kilian261299/mr2-reactive-leds/firmware/mr2-reactive-leds/README.md

# Firmware

This document describes the development of the MR2 Reactive LEDs firmware.

---

# Version History

## v1.0 – Initial Reactive Lighting

The first complete version of the firmware implementing the reactive lighting system.

### Features

- Reactive acceleration lighting
- Braking detection
- Left and right cornering effects
- Four diagnostic modes
- Rotary encoder brightness adjustment
- MPU6050 calibration
- Adjustable sensitivity

### Notes

This version used the raw accelerometer readings directly. While effective during normal driving, sustained gradients (such as hills) could cause the LEDs to remain in an acceleration or braking state.

---

## v1.1 – Dynamic Baseline Filtering

Improved acceleration detection by reacting to changes in acceleration rather than absolute sensor readings.

### Improvements

Instead of using the raw longitudinal acceleration value directly, the firmware continuously maintains a slowly updating baseline representing the vehicle's current orientation.

Acceleration effects are then calculated from the difference between the current reading and this moving baseline.

This allows the baseline to gradually follow long-term changes, such as driving uphill or downhill, while still responding quickly to genuine acceleration and braking events.

### Benefits

- Eliminates false acceleration detection on hills.
- Eliminates false braking detection on downhill sections.
- Produces smoother and more realistic vehicle response.
- Greatly improves real-world driving behaviour.

---

## v1.2 – Mode Cleanup

The firmware was simplified following validation of the accelerometer axis orientation and reactive lighting behaviour.

### Changes

- Removed X/Y/Z diagnostic modes.
- Removed one-off Left/Right test modes.
- Removed the White/current test mode.
- Removed the software Off mode.
- Power control is now handled by the physical master toggle switch.

The removal of diagnostic and test modes simplified the user interface and prepared the firmware for use in the final vehicle installation.

---

## v1.3 – New Modes and Effects

The firmware was updated with improved startup behaviour, idle lighting effects, and additional ambient lighting modes.

### Changes

- Added a startup sweep animation.
- Added idle breathing effect to the main reactive mode.
- Replaced the removed software Off mode with four static theme colours.
- Increased the total number of user-selectable modes to five.

### Startup Sweep

A one-off fading chase animation runs across both LED strips when the system powers on.

The startup animation completes before normal MPU6050 accelerometer-based reactive lighting begins.

### Idle Breathing

When the vehicle is stationary or experiencing minimal movement, the reactive lighting mode now produces a gentle breathing effect with an approximately four-second cycle.

The breathing effect is automatically overridden when genuine acceleration, braking, or cornering movement is detected.

### Theme Modes

Four selectable static colour themes were added:

- Purple
- Red
- Blue
- Green

These provide ambient lighting options when reactive vehicle-dynamics lighting is not required.

The firmware now provides five selectable modes in total.

---

## v1.4 – Colour and Reactivity Refinement

The firmware was refined to improve colour transitions and extend reactive behaviour across all lighting modes.

### Changes

- Tuned the acceleration fade target colour to reduce the green channel from 80 to 40.
- Reduced the yellow tint previously visible during the blue-to-orange acceleration transition.
- Extended movement-reactive brightness behaviour to all four theme modes.
- Extended cornering brightness shifts to all four theme modes.
- Extended idle breathing effects to all four theme modes.
- Hand-tuned final purple and green RGB colour values.

### Improvements

The four theme modes are no longer completely static.

They now respond to overall vehicle movement and left/right cornering in the same way as the main reactive mode, while retaining their selected base colour.

This provides consistent reactive behaviour across all five available lighting modes.

---

## v1.5 – Rotary Encoder Reliability Fix

The rotary encoder brightness control was updated to improve reliability and eliminate erratic brightness adjustments.

### Changes

The previous single-edge CLK detection method was replaced with full quadrature decoding.

The new implementation tracks both the CLK and DT signals simultaneously using a state-transition table.

### Improvements

The previous implementation could occasionally detect encoder transitions incorrectly.

This was particularly noticeable when the firmware was busy updating the LED strips, as the large LED update operation could cause the encoder to be sampled during a transition or contact bounce.

This could result in:

- Erratic brightness changes.
- Incorrect direction detection.
- Difficulty reliably reaching minimum brightness.
- Inconsistent encoder behaviour during rapid rotation.

The new full quadrature decoding method tracks valid CLK/DT state transitions and provides more reliable direction detection.

### Result

- Improved rotary encoder reliability.
- Reduced sensitivity to contact bounce.
- More consistent clockwise and counter-clockwise detection.
- Reliable brightness adjustment across the full brightness range.
- Improved ability to reach minimum brightness.

---

## v1.6 – Interrupt-Driven Encoder and Responsiveness Tuning

Following testing of v1.5, the rotary encoder brightness control was further refined.

Although the full quadrature decoding introduced in v1.5 improved direction reliability, brightness adjustment could still become less responsive during rapid encoder rotation.

This was caused by the main firmware loop performing large LED update operations. The two 160-LED strips are updated repeatedly, and these operations can temporarily prevent the encoder from being sampled frequently enough during fast rotation — a rotation could complete, several detents' worth of movement, entirely between two consecutive checks of the encoder pins.

### Moving to Interrupts

Polling (checking the encoder pins once per loop, however good the decoding logic) is fundamentally limited by how often the loop actually gets back around to checking. v1.6 removes that limitation by moving encoder reading onto **hardware interrupts** instead: `attachInterrupt()` is used on both the CLK and DT pins, configured to fire on `CHANGE` (any transition, either direction). This means an encoder transition is captured **the instant it happens**, regardless of what the main loop is doing at that moment — including in the middle of a slow LED strip update.

### Keeping the Interrupt Handler Minimal

The interrupt service routine (`encoderISR()`) does the same quadrature decoding as v1.5 — reading CLK/DT, looking up the transition in the same state-transition table, and accumulating valid movement — but deliberately does **nothing else**. No `Serial` printing, no LED updates, no `delay()`, no floating-point math. This matters because code running inside an interrupt handler blocks everything else on the microcontroller for its duration; keeping it to a few integer operations means it returns almost instantly, so it can't itself become a new source of timing problems. The accumulated movement is stored in a `volatile` counter, which the main loop reads separately.

### Draining Accumulated Movement in the Main Loop

The main loop doesn't do the decoding itself anymore — it just periodically drains whatever the ISR has accumulated (`processEncoderRotation()`). This copy-and-clear step is wrapped in `noInterrupts()`/`interrupts()` to make it atomic, so a transition can't be captured half-read if the ISR fires at the exact moment the main loop is checking it.

Draining uses a loop, not a single check — if several detents' worth of movement built up while the main loop was busy (e.g. during a slow LED update), all of it is applied at once, rather than only the most recent detent and the rest silently dropped. Any leftover partial movement (less than one full detent) is carried over to next time rather than discarded, so a rotation that happens to straddle two loop iterations doesn't lose precision.

### Detent Tuning

`stepsPerDetent` — how many valid quadrature transitions count as one physical "click" of the knob — was reduced from 4 (v1.5) to 2, so the brightness responds more directly to physical movement rather than needing two clicks to register a change.

### Improvements

- Added interrupt-driven rotary encoder handling.
- Both CLK and DT encoder signals are monitored using interrupts.
- Improved brightness adjustment responsiveness.
- Improved encoder performance during rapid rotation.
- Reduced missed encoder transitions when turning the knob quickly.
- Improved reliability during high-frequency LED update operations.
- Maintained reliable clockwise and counter-clockwise direction detection.
- Maintained stable minimum brightness control.
- Improved overall feel of the brightness control during normal use.

### Result

The rotary encoder now provides a more responsive and usable brightness adjustment experience while maintaining the reliability improvements introduced in v1.5.

The encoder can be rotated more quickly without losing as many brightness adjustments, making it easier to move rapidly through the full brightness range. Because encoder transitions are captured by interrupts rather than relying solely on the timing of the main firmware loop, brightness control remains responsive even while the LED strips are being updated.

---

## v1.7 – LED Output and Colour Refinement

The firmware was refined following continued development of the LED output and lighting behaviour.

### Changes

- Reworked LED brightness handling to use manual RGB channel scaling.
- Retained the NeoPixel library at maximum brightness while applying brightness directly to each colour channel before output.
- Improved consistency of colour ratios across different brightness levels.
- Refined the blue-to-orange acceleration colour transition.
- Reduced unwanted green contribution during acceleration colour transitions.
- Tuned the purple theme colour for a deeper, more controlled appearance.
- Retained full breathing effect depth across reactive and theme modes.
- Continued use of smoothed accelerometer values for stable reactive behaviour.
- Retained progressive acceleration, braking, and cornering responses.

### Manual RGB Brightness Scaling

Brightness is now controlled by directly scaling the red, green, and blue channels before the colour is sent to the LED strips.

This avoids relying on `setBrightness()` for normal runtime brightness control.

The approach provides more predictable colour behaviour during:

- Idle breathing.
- Acceleration response.
- Braking response.
- Cornering brightness changes.
- Static theme modes.

### Colour Refinement

The main reactive mode continues to transition from deep blue through a controlled violet-blue stage before reaching warm orange under stronger acceleration.

The green channel is deliberately kept low during the transition to prevent the LEDs from producing an unwanted pale purple, white, or yellow appearance.

The purple theme was also hand-tuned to use a controlled RGB value rather than a full-intensity mixture.

### Result

v1.7 provided a more consistent and visually controlled LED output while maintaining the established reactive lighting behaviour.

The firmware was now ready for further refinement of the accelerometer baseline system and real-world hill compensation behaviour.

---

## v2.0 – Smart Dynamic Baseline

v2.0 builds directly on the established v1.7 LED output, colour handling, reactive behaviour, and rotary encoder system.

The primary improvement in v2.0 is a more robust smart hill-compensation system designed to distinguish between long-term vehicle orientation changes and genuine dynamic vehicle movement.

### Smart Hill Compensation

The MPU6050 measures both gravity and dynamic acceleration.

Because the accelerometer is mounted to the vehicle, changes in vehicle pitch can alter the measured forward-axis acceleration even when the vehicle is travelling at a constant speed.

For example:

- Driving uphill can produce an apparent forward acceleration change.
- Driving downhill can produce an apparent braking change.

The hill-compensation system therefore maintains a slowly adapting accelerometer baseline representing the vehicle's current orientation.

Reactive acceleration and braking behaviour is calculated relative to this baseline.

### Smart Baseline Gating

Unlike the previous continuously adapting baseline system, v2.0 prevents the baseline from adapting during meaningful dynamic vehicle movement.

The baseline is frozen when the system detects:

- Significant forward acceleration.
- Significant braking.
- Significant lateral cornering movement.

This prevents genuine acceleration or braking events from being gradually absorbed into the baseline.

### Baseline State Machine

The smart baseline system operates using three states:

#### STABLE

The vehicle is considered sufficiently calm.

The baseline is allowed to adapt slowly to long-term changes in vehicle orientation.

This allows the system to gradually compensate for sustained gradients such as:

- Uphill driving.
- Downhill driving.
- Long-term changes in vehicle pitch.

#### DYNAMIC

Meaningful vehicle movement has been detected.

The baseline is completely frozen.

This includes:

- Acceleration.
- Braking.
- Cornering.

The baseline remains frozen for as long as meaningful dynamic movement continues.

This prevents genuine vehicle dynamics from being mistaken for a change in vehicle orientation.

#### SETTLING

Dynamic movement has stopped.

The baseline remains frozen temporarily while the vehicle settles.

A settling delay prevents the system from immediately adapting to the end of an acceleration, braking, or cornering event.

If dynamic movement resumes during this period, the system immediately returns to the DYNAMIC state.

Once the settling period has completed and the vehicle remains sufficiently stable, the system returns to STABLE and slow baseline adaptation resumes.

### Smart Baseline Behaviour

The intended behaviour is:

```text
Vehicle stationary / stable
        |
        v
Baseline slowly adapts
        |
        v
Hill or sustained gradient
        |
        v
Baseline gradually follows orientation change
        |
        v
Genuine acceleration detected
        |
        v
Baseline FREEZES
        |
        v
Acceleration held
        |
        v
Baseline remains FROZEN
        |
        v
Acceleration ends
        |
        v
SETTLING period
        |
        v
Vehicle becomes stable
        |
        v
Baseline slowly adapts again
```

### Also Included in v2.0

Carried over and retained unchanged from earlier versions, alongside the new baseline system:

- Accelerometer low-pass filtering.
- Acceleration, braking, and cornering dead zones, to prevent small/noisy movements from triggering reactive effects.
- Progressive (squared) acceleration, braking, and cornering response curves.
- Blue → violet-blue → orange acceleration colour transition.
- Red braking colour.
- Left/right cornering brightness bias.
- Five lighting modes (Main Reactive plus four static themes).
- Rotary encoder brightness control, mode switching (short press), and recalibration (long press).
- Startup sweep animation and calibration confirmation flash.

### Result

v2.0 substantially improved real-world hill behaviour compared to v1.1's always-adapting baseline: genuine acceleration and braking events are protected from being gradually absorbed into the baseline, while sustained gradients are still eventually recognised as the new normal once the vehicle settles.

The remaining limitation was that this entire system relied on the accelerometer alone. An accelerometer physically cannot distinguish "the sensor is tilted" from "the sensor is accelerating" — both produce an identical reading. v2.0's state machine and dead zones manage that ambiguity carefully, but can't fully resolve it. This became the focus of v3.0.

---

## v3.0 – Gyroscope + Accelerometer Sensor Fusion

v3.0 changes the fundamental approach to hill compensation: from accelerometer-only baseline tracking to gyroscope + accelerometer sensor fusion.

The motivation is the limitation identified at the end of v2.0 — an accelerometer alone cannot tell "tilted" apart from "accelerating." A gyroscope resolves this directly: a hill causes the vehicle to physically pitch (a rotation, which the gyro measures), while genuine forward acceleration does not. Tracking that rotation gives a real estimate of the vehicle's pitch angle, which can be used to calculate exactly how much of the raw forward reading is caused by gravity at that angle — and remove only that.

This section covers the full v3.0 development, including issues found and fixed during bench testing rather than a separate version bump — these were fixes to the intended v3.0 design, not new features.

### Gyroscope Pitch Tracking

The MPU6050's gyroscope measures rotation rate. For this vehicle's mounting orientation, pitch (the car's nose rising or dipping) is read from the gyro's Y-axis.

Integrating that rotation rate over time gives a running estimate of how much the vehicle's pitch angle has changed since the last reading.

### Complementary Filter

A pure gyro-integrated angle would drift slowly over time, since small measurement errors accumulate with every integration step. To correct this without losing the gyro's fast, accurate response, the firmware blends it with a second, independent pitch estimate calculated directly from the accelerometer (based on the direction gravity currently appears to be pulling).

The accelerometer-only estimate has the opposite trade-off: no long-term drift, but it's wrong whenever the vehicle is genuinely accelerating, since real acceleration adds to the reading in a way that looks like additional tilt.

The complementary filter blends the two, weighted mostly toward the gyro (98%) with a small continuous correction from the accelerometer (2%) — fast and responsive, but resistant to drift over the course of a drive.

### Accelerometer Reliability Gating

Found during code review: the original implementation always trusted the accelerometer's pitch estimate a little, even during strong acceleration or braking, when it's actively measuring gravity *plus* the vehicle's own motion rather than gravity alone.

The filter now calculates total accelerometer magnitude and compares it to 1g. The further that reading drifts from 1g, the less the accelerometer's pitch estimate is trusted — fading to fully ignored during a hard event, so the filter runs on the gyro alone until things settle back down.

### Gyro Zero-Rate Bias Correction

Found during bench testing: every real gyro reads a small nonzero rotation rate even sitting perfectly still (a manufacturing quirk called bias). Left uncorrected, integrating that constant offset produced continuous phantom pitch drift even when the sensor never moved — enough to get the state machine stuck in `DYNAMIC` permanently.

Fixed by measuring the gyro's average reading during calibration (while the board is genuinely still) and subtracting that measured bias from every subsequent gyro reading.

### Gravity Component Removal

Once the current pitch angle is known, the firmware calculates how much of the raw forward-axis reading is explained by gravity acting through that angle, and subtracts exactly that amount.

What remains is the genuine dynamic (non-gravity) component of the forward reading — real acceleration or braking — regardless of how long the vehicle has been on a slope.

### Gyro Sign Tuning

Same principle as `FORWARD_SIGN`/`SIDE_SIGN` elsewhere in this firmware: the correct sign for the gyro term can't be known in advance, only confirmed empirically. Bench testing showed a clear, consistent asymmetry — tilting nose-down produced the correct colour cleanly, but tilting nose-up briefly flashed the wrong colour before correcting itself. This is the signature of the gyro-integrated estimate momentarily tracking the wrong direction during fast rotation, before the accelerometer correction pulls it back.

Added a `PITCH_GYRO_SIGN` constant for this, flipped from `1` to `-1` based on that test result.

### Changes to the Smart Baseline System

- The forward/longitudinal axis no longer uses an adaptive baseline at all. Pitch compensation replaces that role directly and more accurately.
- The side/lateral axis (cornering) is unchanged — it still uses the v2.0 adaptive baseline, gated by the same state machine.
- The STABLE / DYNAMIC / SETTLING state machine from v2.0 is retained, but now only governs the side-axis baseline. It continues to provide the same protection against transient movement being misread as a change in vehicle orientation.

### Gating Signal Smoothing

Found during bench testing: the state machine's DYNAMIC/STABLE decision compared a raw, unsmoothed movement reading against a fairly tight threshold (0.075g). A single noisy sample could spike past that even at rest, contributing to the state machine getting stuck.

Added a dedicated smoothing pass for this gating signal, separate from the smoothing already used for LED output, applied before the threshold comparison.

### Behaviour

```text
Steady hill, constant speed
        |
        v
Pitch angle stabilises to match the gradient
        |
        v
Gravity's forward component is fully accounted for
        |
        v
LEDs read as calm / blue

Genuine acceleration (flat road or on a hill)
        |
        v
Cannot be explained by the pitch angle alone
        |
        v
Remains in the compensated signal
        |
        v
LEDs react normally
```

### Also Changed

- Renamed `baseX` to `calibrationAccelX` to reflect what it actually does now — a one-time input used to seed the pitch estimate, not an ongoing baseline like `baseY`/`baseZ` still are.
- Serial debug output now reports pitch two ways: absolute angle (what the compensation math actually uses, since gravity's real component depends on true tilt including any fixed mounting offset) and pitch relative to the last calibration (a more human-readable "degrees of hill" figure for reading the debug output).

### Side-Axis Gating: Rate of Change, Not Magnitude

Found during bench testing: the side-axis (Y/Z) state machine only checked the *size* of the movement reading against a threshold, not whether it was actually changing. A genuine, sustained offset (e.g. the sensor disturbed after calibration, then left in its new resting position without being recalibrated) looked identical to active movement — large — and the state machine could get permanently stuck in `DYNAMIC`, unable to ever adapt the side-axis baseline back to reality, since adaptation only happens in `STABLE`, and `STABLE` was never reached.

Fixed by gating on the *rate of change* of the movement signal instead of its raw size. Genuine cornering keeps changing throughout the event and is still correctly caught; a stale offset settles and stops changing, however large it is, and is now correctly allowed through to `STABLE` so the baseline can adapt itself back to reality.

This required rescaling the two threshold constants (`baselineStableThreshold`, `baselineDynamicReentryThreshold`), since a per-loop rate-of-change value is naturally much smaller than the magnitude value they used to compare against. Starting values are a reasonable guess, not yet verified against real driving data.

In practice this fix is expected to be low-impact on normal driving — a freshly calibrated car experiences genuine cornering as both large *and* changing, so the old and new gating logic should behave the same in that case. The difference only shows up in the narrower scenarios the bug affected: a long stop on a slope without power-cycling, or the sensor being disturbed mid-drive.

### Side-Axis Gating: Sustained Cornering Washout (Follow-on Fix)

A direct consequence of the rate-of-change fix above, found by reasoning through it rather than on the bench: a **sustained** corner — a roundabout, a long motorway sweeper, anything held at roughly constant lateral G for a few seconds — looks identical to a settled stale offset from a rate-of-change perspective. Both are "large, but not currently changing." The state machine couldn't tell "this stopped changing because nothing's happening" apart from "this stopped changing because the car is mid-corner at constant radius," so a long enough corner could reach `STABLE` and start adapting the baseline toward the current cornering G — fading the cornering LED effect to neutral while the car was still actively turning.

Mitigated (not eliminated) by slowing down two constants:

- `baselineDriftRate`: `0.05 → 0.003`. Even once `STABLE` is reached, adaptation now takes many seconds rather than well under one.
- `baselineSettleTime`: `750ms → 4000ms`. The state machine won't consider itself settled until a reading has been steady for a full 4 seconds, longer than most ordinary corners.

Together, a normal-length corner shouldn't get far enough through this pipeline to visibly fade; a genuinely stale offset (the sensor bumped and left, a long stop on an incline) still eventually self-corrects, just gradually.

**This is the third fix applied to this state machine without any real driving data to verify any of them against** (stuck-in-DYNAMIC → rate-of-change gating → this washout fix). That pattern was discussed directly: the system's only remaining genuine benefit is self-correcting *within a single drive* if the sensor is disturbed mid-journey, since parking on a slope is already handled by calibrating fresh on every boot, and cornering itself doesn't need it at all. Weighed against three rounds of speculative, unverified fixes, removing the whole system (calibrate `driftBaseY`/`driftBaseZ` once, never adapt, delete the state machine entirely) was seriously considered as the more robust option for the first real car test.

**Decision: keeping it for now**, with this explicitly flagged as a candidate for removal or simplification once real driving data comes in — either confirming it now works correctly, or showing it's not worth the complexity relative to the narrow benefit it provides.

### Untested Consideration: Road Bumps / Surface Noise

Not yet validated on real roads: whether potholes, expansion joints, or general road surface roughness (a real factor on UK roads) could trigger brief false colour reactions.

The two existing defences — dead zones (ignoring anything below `0.04g`/`0.12g`/`0.08g`) and smoothing — are tuned to reject small/gradual noise, but a sharp bump can produce a spike well above those thresholds in a single instant, and the smoothing is deliberately responsive (so genuine hard braking doesn't feel laggy), which limits how much it can reject a brief jolt too. A bump and the start of genuine hard braking look mathematically similar in that first instant — both are a sudden spike — so the system can't yet fully distinguish them by shape, only by size.

Some reason for optimism: the car's suspension sits physically between the road and the sensor, and already mechanically filters out a lot of sharp impact before it reaches the chassis — a bench test shaking the board by hand produces a sharper, higher-frequency jolt than most real bumps transmitted through a sprung, damped suspension, so it's likely a worse-case preview rather than a representative one.

This is one of the specific things to watch for during real-world driving. If it turns out to be a real problem, possible fixes (not yet implemented, each with a trade-off against responsiveness to genuine events):

- Heavier smoothing.
- Wider dead zones.
- A minimum-duration requirement — only react once a spike has been sustained for some threshold (e.g. ~100ms+), since bumps are typically much shorter-lived than genuine acceleration/braking events.

### Post-Install Update: LED Count

Not part of the original v3.0 development — added afterward, once the LED strips were physically cut to fit final mounting. `NUM_LEDS_LEFT`/`NUM_LEDS_RIGHT` updated from `160` to `80` to match. See the build log's "Build Change: LED Strips Cut to Fit Final Mounting" entry for the hardware side of this.

### Result

v3.0 is intended to resolve the core limitation carried through every previous version of the hill-compensation system: rather than carefully managing the ambiguity between "tilted" and "accelerating," it removes the ambiguity directly by using the MPU6050's gyroscope — a sensor that was physically present on the chip all along (the MPU6050 is a combined accelerometer + gyroscope), but whose readings earlier versions requested and then discarded without using. Bench testing confirmed the forward-axis pitch compensation working as intended, including recovering correctly from a large, sustained reorientation.

The side-axis (cornering) baseline system from v2.0 is retained, kept deliberately despite three rounds of unverified fixes during this version (see above) — its narrow remaining benefit (self-correcting mid-drive without a manual recalibration) was judged worth one more real-world test before deciding whether to simplify or remove it.

Firmware was installed for real-world car testing as of this version. See v2.1 below for what that testing found and the resulting development direction.

---

## v2.1 – Field Tuning (Branches from v2.0)

Following real-world driving in both v3.0 and v2.0 (see v3.0's Result above), this version branches from **v2.0**, not v3.0. This section explains why, and documents the one tuning change made so far.

### Why v2.0, Not v3.0

The same drive tested both versions.

**v3.0's result was ambiguous.** Logged data showed the forward-axis pitch estimate swinging significantly (double digits, degrees) during hard acceleration — consistent with the gyro absorbing genuine acceleration as if it were a hill, the exact failure mode the accelerometer-reliability gating was meant to prevent. However, this is **not confirmed** — the test run wasn't verified to be on flat ground, so the same data is equally consistent with a genuine road gradient. Untangling the two requires a controlled test (hard acceleration on confirmed-flat ground) that hasn't been done yet.

**v2.0's result was unambiguous and positive.** Braking and cornering both worked well. A real hill, driven at steady speed, correctly settled to blue. The one clear problem found — acceleration rarely reaching true orange — turned out to be a shared tuning issue affecting both versions equally (see below), not something specific to either compensation approach.

Given one version has a confirmed-working, if imperfect, result, and the other has an open question that needs further isolated testing to resolve, development focus moved to tuning v2.0 rather than continuing v3.0 immediately.

**This is provisional, not final.** v3.0's gyroscope approach isn't abandoned — it's paused pending a proper flat-ground test to resolve the ambiguity above. If that test confirms the drift concern, v3.0 would need real design changes (e.g. limiting how far the gyro can drift before forcing a correction) before it's worth continuing. If it turns out to be genuine road gradient all along, v3.0's approach may simply need the same kind of tuning v2.1 is getting here.

### Change: Acceleration Response Range

`accelerationResponseG` lowered from `0.35` to `0.18`.

Logged driving data (from the same drive, captured while running v3.0 — the underlying accelerometer data is the same sensor either way) showed hard acceleration peaking around `0.17g`. Against the old `0.35` target, even a hard launch only reached partway through the blue → orange transition — a brief violet flash, never true orange, matching what was reported: "can only briefly get it to go purple to orange when taking off very fast in 1st gear." `0.18` was chosen just above that logged peak.

This is a first estimate from a single data point, not a fully characterised response curve. May need further adjustment once more driving data — a range of gentle/moderate/hard accelerations, not just one hard launch — is available. Braking (`brakingResponseG = 0.40`) and cornering (`corneringResponseG = 0.35`) were left unchanged, since both were already reported working well.

### Change: LED Count

`NUM_LEDS_LEFT`/`NUM_LEDS_RIGHT` changed from `160` to `80`, matching the LED strips as physically cut for final mounting. v3.0 already had this fix (it was made directly to v3.0 while that was the active version); v2.0 did not, since it wasn't in active use when the strips were cut. Now carried over to v2.1 since this is the version actually being run in the car.

### Also Noted (Not Yet Changed)

**Braking doesn't trigger during upshifts in v2.0**, unlike v3.0 where it did. Likely explanation: v2.0 doesn't have v3.0's pitch-compensation erosion pulling the forward signal down toward zero during sustained acceleration, so the smoothing filter has a genuinely elevated, stable signal to blend against — a brief upshift dip may get partially smoothed out rather than crossing the braking threshold. Considered low priority (cosmetic, not core reactive behaviour) and not addressed in this version.

### Result

v2.1 is the currently active development branch, based on v2.0's confirmed-working real-world behaviour rather than v3.0's still-unresolved pitch question. The one identified shared issue (acceleration response range) has been corrected with a first-estimate fix, pending further driving data to refine it. v3.0 remains available and is not considered abandoned — see "Why v2.0, Not v3.0" above for what would need to happen to revisit it.

**Confirmed on further real driving**: braking and cornering both continued to work well. Acceleration correctly reached true orange with the tuned response range — confirming that fix. A new issue was found: on a sufficiently long, sustained acceleration, the display could fade back to blue before the acceleration actually ended.

**Note on file integrity**: partway through investigating the fade issue below, an intermediate build was briefly and mistakenly shipped as "v2.1" with the (later rejected) full-freeze fix already applied, differing only in its internal version label. This was caught and corrected — the file distributed as v2.1 is confirmed to match the description in this document exactly (tuned acceleration response and LED count only, nothing else). Documented here for a clean record; no impact on the firmware description above.

**The fade issue, investigated**: traced to `gravityX/Y/Z`, a tracker that feeds the STABLE/DYNAMIC/SETTLING gating decision. Unlike `driftBaseX/Y/Z` (the actual output baseline, which correctly freezes during `DYNAMIC`), this tracker was updating unconditionally, every loop, regardless of state. Over several seconds of genuinely sustained acceleration, it would slowly catch up to the elevated reading, shrinking the gating signal toward zero even though real acceleration was still happening — eventually fooling the state machine into thinking things had calmed down, which released the real baseline to re-adapt and fade the display.

**A full fix was built and reasoned through, but not shipped.** Freezing `gravityX/Y/Z` during `DYNAMIC`/`SETTLING` (the same way the real baseline is already protected) does stop acceleration from fading — but the same signal also does a second job: eventually recognising that a sustained reading is a real hill, not an event, and releasing the baseline to absorb it as the new normal. Freezing it unconditionally removes that second job too. A plain accelerometer genuinely cannot tell "long sustained acceleration" apart from "constant-grade hill" — both produce the same signal, held roughly constant over time. This is the same structural ambiguity v3.0's gyroscope exists to resolve; there is no cleverer accelerometer-only heuristic that resolves it. Given the choice between "hills fade correctly, acceleration can prematurely fade" (v2.1's original behaviour) and "acceleration never fades, hills likely never fade either" (the full fix), the full fix was judged a worse trade-off, not a genuine improvement, and was not shipped as v2.2.

---

## v2.2 – Milder Acceleration-Hold Tuning

Branches from the confirmed-clean v2.1 above. A milder compromise for the same fade issue, rather than the full (rejected) fix — slows down the relevant trackers instead of freezing them, buying more headroom for genuine sustained acceleration without removing hill-absorption altogether.

### Change: Slower Gating Tracker

`gravitySmoothing` lowered from `0.008` to `0.003`.

Rather than freezing this tracker during `DYNAMIC` (the rejected full fix), it's simply slowed down — roughly tripling how long a sustained reading needs to persist before being treated as "the new normal," based on this loop's approximate rate (around 2.5s before, around 6–7s now). A typical hard acceleration run (a few seconds) should get meaningfully more headroom before fading; a genuine hill (tens of seconds or more) should still be absorbed correctly, just somewhat more slowly than before. Both directions are affected together — this doesn't resolve the underlying ambiguity, only shifts where the trade-off sits. Untested at time of writing.

### Change: More Stubborn Dynamic Re-Entry

`baselineDynamicReentryThreshold` lowered from `0.075g` to `0.055g`.

Makes the state machine more reluctant to consider things "calm enough" once an event is underway, so a brief lull during a sustained pull is less likely to let it slip back toward `STABLE` prematurely. Same event-holding goal as the change above, different mechanism. Untested at time of writing. If the combined result overshoots (things stay "locked in" for too long, e.g. noticeably after a real stop), this is one of the knobs to walk back individually.

### Change: Split Smoothing Constants (Acceleration, Braking, Cornering, Movement)

Previously, one shared `accelerationSmoothing` constant governed the low-pass filtering for acceleration, braking, cornering, *and* the theme modes' overall movement brightness — despite the name, it wasn't acceleration-specific at all. This meant tuning it to help acceleration hold its colour longer would have also made braking and cornering feel less snappy, even though neither was part of the problem being fixed (both were already reported working well).

Split into four separate constants:

- `accelSmoothing = 0.10` — acceleration only. Lowered from the previous shared `0.15`, for a steadier displayed colour, less prone to dipping during a brief lull in a sustained pull. Trade-off: slightly slower to reach full colour at the start, and slightly slower to fade back to blue once acceleration actually ends.
- `brakeSmoothing = 0.15` — braking only. Restored to the original value, left untouched.
- `corneringSmoothing = 0.15` — cornering only. Restored to the original value, left untouched.
- `movementSmoothing = 0.15` — theme modes' movement brightness only. Restored to the original value, left untouched.

The forward-axis filter now picks `accelSmoothing` or `brakeSmoothing` each loop based on the current raw reading's sign — a single continuous filter over one signal (`smoothedForwardG`), but with a blend rate that can change depending on whether the current instant looks like acceleration or braking.

### Expected Behaviour Change, v2.1 → v2.2

All three changes above act in the same direction — more reluctant to release an active reading. Expected effects, by scenario:

- **Short, everyday acceleration**: little to no noticeable change.
- **Long, sustained hard acceleration** (the target case): should hold its colour noticeably longer before fading, if it fades within a typical pull at all.
- **Real hills at steady speed**: likely to take longer to settle to blue than v2.1 did — this is the actual cost of the fix, not an unintended side effect, and the main thing to verify on the next real hill test.
- **Braking**: should feel unchanged from v2.1, now that its smoothing is isolated from the acceleration-specific tuning.
- **Cornering**: should also feel unchanged, for the same reason.

### Result

**Confirmed on real driving.** Works well overall, mainly noticeable accelerating in 1st and 2nd gear. Braking and cornering unaffected, as expected.

Two things found:

- **Higher gears rarely reach true orange.** `accelerationResponseG` (0.18) was set from a single logged 1st-gear launch peaking at 0.17g. Higher gears produce much lower forward g for the same "hard acceleration" feel, so they were likely peaking well under 0.18g the whole time. Addressed in v2.3 below.
- **Very steep downhill sections trigger braking (red) heavily/frequently**, beyond what the actual brake pedal input alone would suggest. Not addressed in v2.3 — see that section for why this is a harder problem than the acceleration one.

---

## v2.3 – Higher-Gear Acceleration Tuning

Branches from v2.2, based on its first real driving feedback (above).

### Change: Acceleration Response Range, Again

`accelerationResponseG` lowered from `0.18` to `0.12`.

0.18 worked for 1st/2nd gear but higher gears (lower forward g for the same "hard" feel, due to less torque multiplication) rarely reached orange at all. 0.12 gives higher gears more room on the ramp.

**This is a physics-based estimate, not measured data.** Unlike the original 0.18 figure — derived from a real logged data point — there's no way to log a real number for higher-gear pulls anymore: the board now runs permanently on vehicle power, and USB (needed for Serial logging) can never be connected at the same time as vehicle power (see the build log's backfeed entry). The next drive on this value is the test. If normal light-throttle driving now reaches orange too easily, raise back toward ~0.15; if higher gears still don't get there, lower further toward ~0.09–0.10.

### Steep Downhill Braking: Investigated, Not Fixed Here

Also reported from the same v2.2 drive: very steep downhill sections trigger heavy, frequent braking (red) beyond what the actual pedal input would suggest.

**Root cause identified at the time:** a steep grade change freezes `driftBaseX/Y/Z` (see `updateSmartBaseline()`) the same way genuine braking does — and on a winding descent, repeated real braking can keep that baseline frozen for the whole hill, since each brake application resets the freeze/settle timer before the baseline ever catches up to the new pitch angle. The leftover gravity offset from the grade then stacks on top of genuine brake input, reading as harder and more frequent braking than the pedal alone caused.

At the time, this was believed to be an inherent, unfixable ambiguity of the accelerometer-only approach. **That turned out to be incomplete** — see v2.3's Result below and v2.4.0/v2.4.1, which found and fixed a specific contributor to this that had nothing to do with the fundamental hill-vs-braking ambiguity.

### Code Review Follow-Up (Before First Drive)

A code review of this file, run before it had been driven, found several issues fixed in place rather than shipped as a separate version — none of them re-tune the values above:

- **Modes 1–4 were silently decoupled from the acceleration tuning.** The static colour themes scaled their movement brightness against a hardcoded `0.50g` threshold that had never moved across three rounds of `accelerationResponseG` tuning (`0.35` → `0.18` → `0.12`). They now use `accelerationResponseG` directly. **This is a genuine, previously-unnoticed bug fix and a real behaviour change** — Modes 1-4 will now swing to full brightness much more readily than before, where they barely reacted to movement at all.
- `calibrateMPU6050()` now refuses to run (flashes red, returns immediately) if the vehicle isn't stationary, instead of silently averaging a moving-vehicle reading into the calibration baseline on an accidental long-press while driving.
- The repeated "dead zone → range → ratio → clamp → square" intensity curve (acceleration, braking, cornering, theme brightness) was unified into one `squareRatio()` helper, which also floors its range argument away from zero — closes off a possible future divide-by-zero if `accelerationResponseG` is ever tuned down close to `accelerationDeadZone`.
- Removed dead code: three unused `baseline*Threshold` constants, and an unreachable re-check inside `updateSmartBaseline()`'s SETTLING state.
- Minor efficiency/robustness cleanup: `setStrip()` now skips rewriting LED data when output is unchanged from the previous frame; `blueToOrange()` is called once per loop instead of twice; the gravity "not yet initialised" check now uses an explicit flag instead of a fragile exact-zero float comparison.

### Result

**Confirmed on real driving.** Works "almost perfectly": higher gears now reach true orange (confirming the `0.12` tuning), and Modes 1-4 are confirmed noticeably livelier (confirming the code-review fix). Braking and cornering unaffected, as expected.

**One new issue found, not present on earlier versions:** flickering between red (braking) and blue (idle) while going downhill, with no braking input needed at all — a different, more disruptive symptom than the "heavy/frequent braking" originally reported on v2.2. Traced back to **v2.1 → v2.2** (not this version's own acceleration-threshold change or code review): v2.2's `gravitySmoothing` and `baselineDynamicReentryThreshold` changes, made specifically to help sustained acceleration hold its colour, also slowed how fast a downhill grade gets absorbed and made the state machine easier to re-trigger before it settled — together producing a freeze/partial-catch-up/re-trigger cycle on hills. Fixed in v2.4.0 below, without reverting the acceleration benefit.

---

## v2.4.0 – Downhill Flicker Fix, Attempt 1 (Superseded)

Branches from v2.3, fixing the downhill red/blue flicker found on that version's first drive (see v2.3's Result above).

### Change: Direction-Aware Gravity Smoothing (Forward Axis Only)

`gravitySmoothing` (0.003, the v2.2 rate that protects sustained acceleration from fading) is no longer applied uniformly to the forward axis. A new constant, `gravitySmoothingBraking` (`0.008`, the original pre-v2.2 rate), is used instead whenever the current forward-axis excursion is in the **braking direction** — which a downhill grade shares, since both show up as a sustained shift on the same axis, same sign.

This works because acceleration and braking/downhill-grade are distinguishable by sign on the same axis, even though an accelerometer can't otherwise tell "tilted" from "accelerating." Each loop, `readAcceleration()` checks the sign of the raw forward reading relative to the current gravity estimate (before that estimate updates) and picks the smoothing rate accordingly:

- **Accelerating** → `gravitySmoothing` (`0.003`, unchanged from v2.2/v2.3) — sustained hard pulls still get the full ~6-7s of held colour before the baseline would start absorbing them.
- **Braking / downhill** → `gravitySmoothingBraking` (`0.008`, restored) — the baseline recognises and absorbs a hill grade at roughly the v2.1 rate again, well before the freeze/re-trigger cycle has a chance to repeat visibly.

This is a different kind of fix than the blunt mitigations considered and rejected for v2.3 (raising `brakingDeadZone`/`brakingResponseG`, which would have dulled genuine light braking everywhere). It doesn't touch the dead zone or response range at all — it only changes how fast the *gating* signal recognises a sustained condition, and only in the direction where fast recognition doesn't cost anything: real braking already ran fine at this exact rate across v2.0 and v2.1, before v2.2 slowed it down uniformly for acceleration's sake.

`baselineDynamicReentryThreshold` (`0.055`, also lowered in v2.2) was **left unchanged**. The gravity-rate split should already resolve the flicker by keeping the gating signal closely tracked during braking/downhill excursions; if flicker persists, that threshold is the next thing to revisit.

### Result

**Drive-tested: no improvement.** Downhill flicker unchanged from v2.3. Uphill and flat were both unchanged too — but they were already fine before this change, so that's not evidence the fix did anything; it's consistent with the fix having no effect at all.

**Root cause of the fix not working:** a hill pitch doesn't only shift the forward axis (X) — it shifts the vertical axis (Z) at the same time, since both are involved in the same rotation. This version only made `gravityX` direction-aware; `gravityZ` was left on the plain, slow `gravitySmoothing` rate throughout. Since the state machine's gating signal (`dynamicMovementG`, in `updateSmartBaseline()`) is a combined magnitude across all three axes, `gravityZ`'s slow recovery kept that combined signal elevated for the old ~6-7s duration regardless of how fast `gravityX` alone recovered — so the baseline never got released to adapt any sooner than it did on v2.3. Fixing one of the two coupled axes did nothing on its own. Fixed in v2.4.1 below.

---

## v2.4.1 – Downhill Flicker Fix, Attempt 2 (Final Version, Confirmed)

Branches from v2.4.0, extending the direction-aware fix to the axis it missed.

### Change: Extend the Direction Split to gravityZ

`gravityZ` now uses the same `gravitySmoothingForward` rate and the same direction flag as `gravityX` (not a separate one) — a hill/braking event is fundamentally a forward-axis phenomenon, and `gravityZ`'s shift is a side effect of that same event, not an independent one needing its own direction test. `gravityY` (the lateral/cornering axis) is left on the plain `gravitySmoothing` rate — a straight hill, with no steering input, shouldn't significantly couple into that axis, and cornering already has its own separate handling.

With both coupled axes now settling quickly in the braking/downhill direction, the combined gating signal should drop below threshold at roughly the v2.1 rate again, letting `driftBaseX/Y/Z` resume adapting as soon as v2.4.0 intended it to.

`baselineDynamicReentryThreshold` (`0.055`) is still unchanged. If flicker persists even with both axes fixed, that threshold — which governs how easily the state machine gets knocked back into "frozen" by any remaining noise or disturbance on the hill, independent of how fast the gravity trackers themselves recover — is the next and now more likely culprit.

### Result

**Confirmed on real driving.** Built immediately following v2.4.0's failed drive test; the next drive confirmed it worked — the downhill flicker is gone, and acceleration-hold and braking both feel unchanged from v2.2/v2.3, exactly as expected since this fix only touched how fast the hill-compensation baseline settles.

**v2.4.1 is confirmed as the final firmware version — the core reactive-LED project is complete.** `baselineDynamicReentryThreshold` was flagged as the next thing to try if this didn't work; since it did, that's no longer a live concern. v3.0/v3.1's gyroscope approach remains parked, not needed after all.

---

## v3.1 – Ported Tuning, Gyro Fusion (Parked, Not Pursued Further)

Branches from v3.0: the same acceleration response tuning as v2.1 (`accelerationResponseG` to `0.18`), plus `pitchComplementaryAlpha` lowered from `0.98` to `0.90` in an attempt to reduce the pitch drift seen in v3.0's original real-world test.

Tested once, visually. Braking worked well. Acceleration briefly reached orange only under hard 1st-gear launches, fading back to blue in under a second even while still accelerating — noticeably faster than v2.1's fade, not slower. The timing closely matches the pitch drift seen in the original v3.0 log, strengthening (though not fully confirming, absent a controlled flat-ground test) the theory that the gyro is absorbing genuine acceleration as if it were a hill.

**Parked, not pursued further.** v3.0/v3.1's gyroscope approach was expected to outperform the accelerometer-only v2.x line at exactly this problem; the one real-world test so far suggested the opposite. v2.x's line of tuning reached a good enough result with v2.4.1 (adopted as the final firmware version, see above), so the flat-ground test that would have properly settled the pitch-drift question was never needed and won't be pursued. Not deleted or considered a dead end in principle — just not required to finish this project.

---

## v4.0 – Audio-Reactive Mode (Drafted, Not Yet Bench-Tested)

New version *line*, not a v2.x point release — branches from the final `v2.4.1` above (v3.x's gyroscope work is parked and unrelated), adding the [audio-reactive LED feature](../../docs/audio-reactive-led-plan.md) on top of it. Nothing about v2.4.1's hill-compensation/baseline system changes; Mode 0 and the remaining theme modes are untouched.

### Change: Mode 1 Replaced Entirely

Mode 1 (previously a fixed purple theme, brightness-only reactive to movement like Modes 2–4) is replaced by a new audio-reactive mode — not added as a 6th mode, an explicit choice to keep the mode count at five. Modes 0, 2, 3, 4 keep their existing numbers and behaviour unchanged; only what used to live at slot 1 is different.

Ported from the bench-test sketch (`firmware/tests/04_audio_reactive_test/`), validated there against real music: reads the conditioning circuit's envelope on `GPIO1` (identical pin on both the bench-test board and this production board — the same chip, by design, so no remapping was needed), smooths it with the same fast-attack/slow-release curve, and drives a bar-graph visualizer — a growing/shrinking bar with a bouncing peak-hold marker — across **both** strips identically, rather than the whole-strip solid colour every other mode uses. One mono envelope, no left/right distinction the way cornering has one.

Colour snaps from cyan (quiet) to orange (loud) once the level clears a threshold, using **separate on/off thresholds** (hysteresis) rather than one — a single threshold let the level jitter right at the boundary on real music, which read as a rapid cyan/orange flicker blending into a washed-out white; a real bug hit and fixed on the bench-test sketch first, then carried over here from the start.

The bar's *length* represents audio level (the whole point of the visualizer) — its *LED brightness* is a separate, independent thing, capped by `userBrightness` exactly like every other mode's colour is, using the same scaling maths `setStrip()` already uses elsewhere in this file. The rotary encoder's brightness dial dims/brightens Mode 1 exactly like it does Mode 0.

### Change: Serial Safety Fix Applied File-Wide

`Serial.availableForWrite()` guards added not just around the new audio debug fields, but around the pre-existing periodic debug block and the mode-change print inherited from v2.4.1 — neither had this guard before. Same native-USB-CDC blocking bug found on the ESP32-C3 bench-test sketch: without a Serial Monitor open to drain the buffer, an unguarded print can block indefinitely and freeze the whole `loop()`, LEDs included. Not something the installed v2.x line has ever hit (it runs on permanent vehicle power, USB never connected there), but this file will be bench-tested and installed over USB during Phases 3–4, so it was worth fixing everywhere in this file, not just in the new code.

### Known Placeholder: audioFloor / audioCeiling

Carried over unchanged from Phase 2 bench testing (laptop/phone audio via a USB-C dongle): `audioFloor = 900`, `audioCeiling = 1300`. Almost certainly wrong for the real car radio — different source strength, a volume-dependent preout level, and BAT85 replacing the bench's 1N4007 all change the numbers these were calibrated against. Both are clearly commented in-file as needing retuning from real Serial readings once connected to the actual radio, the same way the originals were derived on the bench.

### Result

**Compiles clean** — 0 errors, 0 warnings — against the real `ESP32-C3 Super Mini` target (`esp32:esp32:nologo_esp32c3_super_mini`) via `arduino-cli`. **Not yet bench-tested**: the conditioning circuit components are with the `v2` PCB, not available for a bench rebuild at time of writing. First real test will be a semi-install directly against the car radio during Phase 4, powered over USB (never simultaneously with vehicle power) so Serial stays available for calibrating `audioFloor`/`audioCeiling` against real numbers.
