kilian261299/mr2-reactive-leds/docs/audio-reactive-led-plan.md

# Audio-Reactive LED Feature — Build Plan

A new, optional mode for the MR2 Reactive LEDs project: LEDs react to music from the car radio, in addition to the existing acceleration/braking/cornering reactivity. This is an addition layered on top of the completed core project — it does not replace or modify the existing v2.x firmware line.

---

## Circuit Design

**Note on D1 (the rectifier diode):** using a 1N4007 rather than the more typical small-signal choice (e.g. 1N4148) for this role, based on what was already on hand. The 1N4007 is a general-purpose power rectifier with much slower switching than a dedicated signal diode — normally a mismatch for audio-frequency work, but not a practical problem here, since the smoothing capacitor (C1) is deliberately the slow part of this circuit already, turning the rectified signal into a "how loud is the music right now" envelope over hundreds of milliseconds. The diode's speed was never going to be the limiting factor for something changing that slowly.

### Signal path overview

```
Front Left RCA  ──┐
Front Right RCA ──┼── mono-summed at the tap point
RCA ground/shield ─┘  (tapped in parallel — never cut the cable in series)
        │
        ▼
Conditioning circuit (see component list below)
        │
        ▼
ESP32 ADC pin (reads a 0–3.3V audio envelope)
        │
        ▼
Firmware: smooth (fast attack, slow release), drive a bar-graph visualizer
        │
        ▼
WS2812B LED strips (existing LEFT_LED_PIN / RIGHT_LED_PIN)
```

### Testing setup — full pipeline

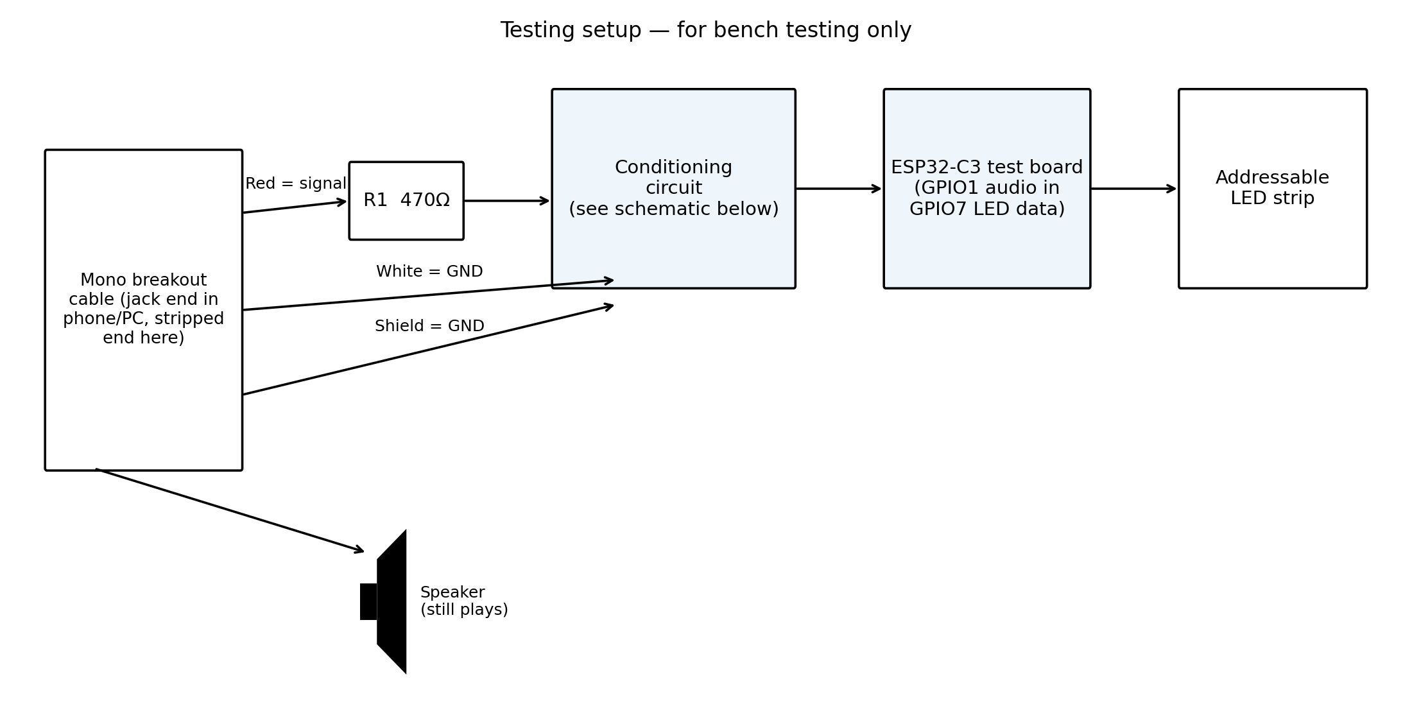
[picture p20: images/audio-circuit/testing_setup_overview.png]
Testing setup overview


This is the complete bench-test signal path: a 3.5mm breakout cable (jack end into a phone or PC, stripped end wired to the circuit), summed and conditioned, into a spare ESP32-C3 module, driving the addressable LED strip. This is the testing configuration only — the production install uses the car's actual RCA tap and the ESP32-C3 installed in the car, not a phone/PC or this spare board.

A small monitoring speaker is also tapped across the R wire and shared ground (not part of the conditioning circuit itself) so you can hear what's actually playing while watching the LED/Serial response — useful for correlating specific sounds (bass hits, vocals, silence) with the tuned behaviour during Stage A/B below.

**Testing board update:** originally planned around a full ESP32 dev board (`GPIO34`/`GPIO5`). A spare ESP32-C3 module turned out to be available instead, which is actually simpler: it's the same chip as production, so the audio ADC pin (`GPIO1`) is identical on both, and Phase 2 tuning carries straight into Phase 4 with no pin remapping. See the updated pinout table below.

### Testing circuit — schematic

Testing circuit schematic

### Testing circuit — component list

```
Red wire (signal) → R1 (470Ω) → D1 (1N4007) → Node B
White wire (ground — see note) ─┐
Shield wire (ground) ───────────┴── GND

Node B → C1 (2.2µF) → GND

Node B → R6 (10kΩ) → GND

Node B → ESP32-C3 (spare test module) GPIO1 (ADC input)
```

A small monitoring speaker taps directly across the red wire and shield, *before* R1 — a separate parallel branch off the raw source connection, not part of the conditioning circuit's signal path.

**White wire note:** on this particular breakout cable, the "white" wire turned out to have continuity with the shield — it's a second ground/drain wire, not a real left-channel conductor (common on cheap 3.5mm pigtail cables, which don't follow RCA's white=L/red=R convention). It ties to the same GND node as the shield, alongside the shield wire itself. There's no second resistor for a left channel here — testing runs mono, through the single R1 in series with red.

**R5 removed (design correction):** the original two-resistor bias network (R5 to 3.3V, R6 to GND) set Node B's resting/silent voltage at their midpoint, 1.65V. ([Archived schematic showing the original circuit with R5, and the R3/R4 divider before it was changed and later removed](../images/audio-circuit/testing_circuit_schematic_original.png) — kept for reference since the current schematic no longer shows these. **Note:** that image also labels the white wire as the left-channel audio input, reflecting the assumption at the time — later found to be wrong for this specific cable, whose white wire is actually a second ground/drain conductor; see the white-wire note above.) Worked through numerically against the divider's realistic output at the time, that's a problem: D1 only conducts once Node A exceeds Node B's voltage by its own forward-voltage drop, so a 1.65V resting point demands roughly 2V+ at Node A just to register anything — but Node A's actual peak was nowhere near that. The diode would essentially never conduct; the circuit would sit at a fixed ~1.65V regardless of music. Dropping R5 and keeping R6 alone as the only path to ground brings the resting point down to ~0V instead, so D1 only needs to clear its own ~0.3–0.6V forward drop. This is also just the standard, single-resistor diode-envelope-detector topology; R5 wasn't buying anything a plain design doesn't already handle better.

**R3/R4 removed entirely, R1 (the resistor in the red/signal path) reduced 2.2kΩ → 470Ω (further design correction, same root cause).** *(Heads up: "R3"/"R4" get reused below for different, unrelated components in the production designator scheme — see the renumbering note in the production section. These two facts aren't connected; the numbers just get recycled once they're free.)* R3/R4 started at 10kΩ:1kΩ, then 1kΩ:1kΩ, sized each time as ADC-protection headroom against an unconfirmed car radio signal. Bench testing with the 1kΩ:1kΩ divider still in place showed the circuit essentially dead — no response to music at all — because the combined attenuation through R1 (2.2kΩ at the time) plus the R3/R4 divider left too little signal for D1 to ever clear its own conduction threshold. Removing R3/R4 entirely and reducing R1 to 470Ω (still enough to isolate the two channels during summing and protect the source from a dead short, just without adding unnecessary attenuation on top) restored a real, visible response on the bench. This is safe for the production circuit too: with no divider at all, the ADC is protected purely by D1's own forward drop — see the confirmed radio-voltage note in the production section for the resulting margin.

**A DC-blocking coupling capacitor was also tried on this breadboard, and reverted.** A large, non-audio baseline jump appeared the instant the laptop's audio cable was connected, before any music played — most likely a DC bias specific to that laptop's headphone output. A first attempt at fixing it (two polarized electrolytics wired back-to-back) failed and stayed failed even after reseating, so it was removed from the circuit shown above — it was never actually working on this breadboard. See the C4/R5 notes in the production section for the full diagnosis and why it's still going into `v2` despite that failure.

### Production setup — full pipeline

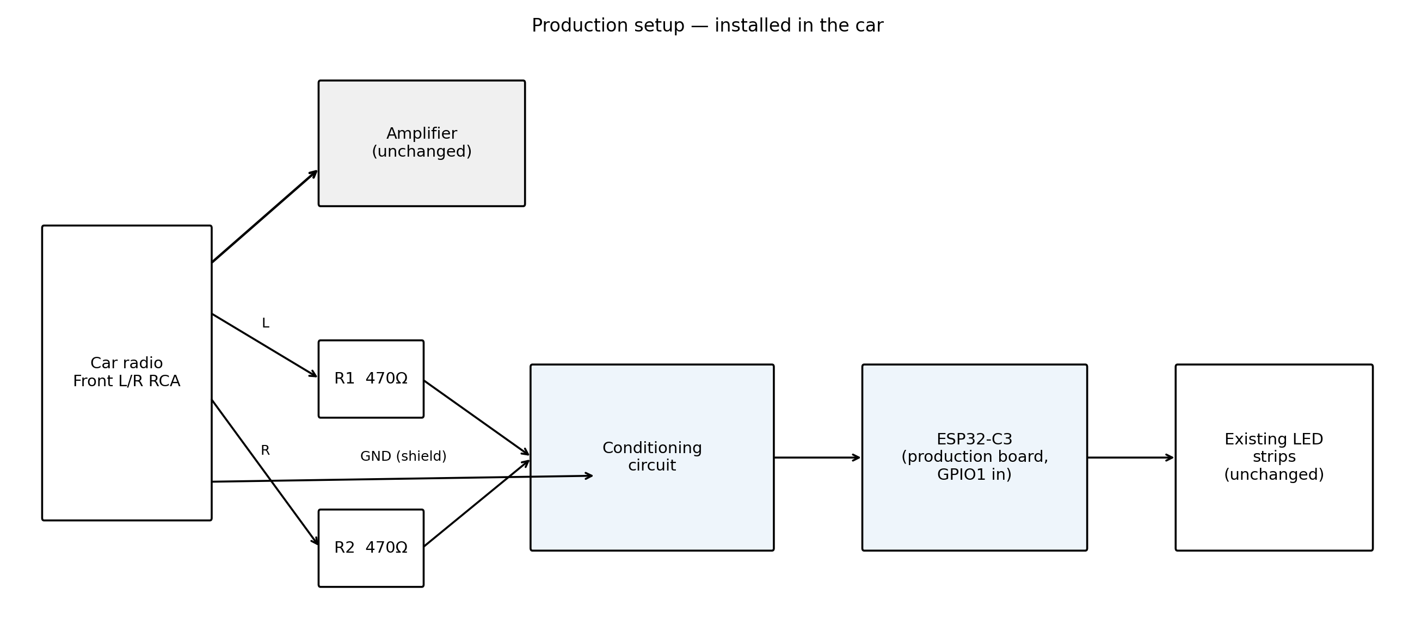
[picture p21: images/audio-circuit/production_setup_overview.png]
Production setup overview


Same Y-split concept as the testing pipeline, now with the real components: the radio's Front L/R RCA (plus shield/ground) splits to the amplifier, completely unchanged, and separately to the new conditioning circuit → ESP32-C3 → the existing LED strips. No new strip or amp wiring — everything downstream of the ESP32-C3 already exists.

### Production circuit — schematic

Production circuit schematic

### Production circuit — component list

```
Front Left RCA  → R3 (470Ω*) ──┐
Front Right RCA → R4 (470Ω*) ──┼── Node S
RCA shield/ground → GND
   (shared ground reference for the whole circuit — see Ground
   note below, this must be the RCA tap's own shield, not a
   separate chassis point)

Node S → C4 (coupling cap, non-polarized, 2.2µF) → Node A
Node A → R5 (4.7kΩ) → GND

Node A → D1 (BAT85) → Node B

Node B → C3 (2.2µF*) → GND

Node B → R6 (10kΩ) → GND

Node B → ESP32-C3 GPIO1 (ADC input, production board)
```

**Note: the production schematic uses different designators, and isn't just a renumbered copy of the testing circuit.** The testing circuit above only has R1 (isolation), R6 (discharge), and C1 (smoothing) — no coupling cap or reference resistor, since that stage was never validated on the breadboard, and only one isolation resistor since only one channel (red) turned out to be usable on this cable. Production genuinely needs two isolation resistors (R3 *and* R4, one per real stereo channel from the RCA tap) plus the coupling cap/reference resistor (C4/R5), so it isn't a 1:1 relabeling of the testing parts — see the production component list below for the full picture. Designators had to move regardless, since `v1`'s real board already uses `R1`/`R2` (330Ω) and `C1`/`C2` (1000µF/100nF) for other components, so production continues numbering straight on from those instead. (One quirk worth flagging: production's `R5` here is unrelated to "R5" in the R5-removal note above, which refers to a different, testing-circuit-only component from earlier in this circuit's history.)

`*` marks values confirmed as a *working starting point* from Phase 2 bench testing (laptop/phone audio) — currently the same as the testing circuit's values. They are **not yet confirmed against the real car radio**; that only happens during Phase 4's install, since the car's RCA wiring isn't accessible before then. Fabricate `v2` with these values populated as-is — if Phase 4's real-radio test shows they need correcting, that's a simple hand-swap of the physical part, not a re-fab (see Phase 4's checklist). Only remove the `*` and update this list once that real-radio confirmation has actually happened. There is no longer a dedicated divider stage (the old R3/R4 divider from the testing-circuit's history, removed entirely — see the note above); R3/R4 here exist only to isolate the two channels during summing and protect the source from a dead short, not to attenuate the signal, and the ADC-protection margin now comes purely from D1's own forward drop against the Kenwood DPX-07MD's confirmed preout spec. C4/R5 (the coupling cap and its reference resistor) aren't marked, since they're a protective addition rather than a level-tuned value — see the note above for why C4 specifically must be non-polarized. R6 isn't marked either, for the same reason — but see the R5-removal note above: earlier versions of this doc paired the discharge resistor with a pull-up to 3.3V that turned out to make D1 never conduct at realistic signal levels, so that pull-up has been dropped from the design entirely.

Now that testing uses a spare ESP32-C3 module (see "Testing board update" above), this circuit and the testing circuit are topologically similar, down to the same `GPIO1` ADC pin — but no longer identical: besides the input source (a phone's 3.5mm jack for testing vs. the real Front L/R RCA here) and which physical ESP32-C3 module it's wired to, production also adds C4/R5 and uses D1 as a BAT85 rather than the testing circuit's 1N4007 — neither was ever part of the validated breadboard circuit, so both are explained here rather than in the testing section above.

**Car radio preout voltage — confirmed, not estimated.** Only relevant to production, since testing never involves the actual radio: the Kenwood DPX-07MD's own service manual (`仕様一覧` / specifications page) lists `プリアウトレベル (FM): 1.8V/10kΩ` — a rated preout level of 1.8V RMS into a 10kΩ load, per channel (each channel has its own independent output stage — not a combined/shared figure). That's the output stage's own voltage-swing ceiling (the same hardware drives every source — CD, MD, AUX, tuner — the "(FM)" just notes the test condition used to rate it), so a full-scale peak works out to roughly 1.8V × √2 ≈ **2.55V peak**. R3/R4 sum Left and Right into Node S via two equal (470Ω) resistors, which *averages* the two channels rather than adding them — so even with both channels simultaneously at their individual peak, Node S never exceeds a single channel's own peak (2.55V), not double it.

**C4/R5 — DC-blocking coupling capacitor, added for production.** Bench testing (with the testing circuit's original C2/R7, before the production renumbering) surfaced a large, non-audio baseline jump the instant the laptop's audio cable was connected, before any music played — most likely a DC bias specific to that laptop's headphone output; ground loops and cable faults were both tested and ruled out as the cause. C4 (a coupling cap between Node S and Node A) blocks that steady bias while passing real audio through; R5 gives the post-cap node a defined reference to ground rather than leaving it floating. This is standard practice for audio inputs generally, and while a proper automotive RCA preout is usually already internally AC-coupled (so the real radio may never have needed this), it's cheap insurance on a board being re-fabbed anyway, and directly protects against the class of problem just observed on the bench.

**Correction (found via Multisim simulation, after the board was already ordered): R5 was originally spec'd at 100kΩ, based on an incomplete analysis — corrected to 4.7kΩ.** The original reasoning only modelled C4/R5 as a simple AC high-pass filter, and on that basis alone 100kΩ looked ideal (barely attenuates audio at all, see the transfer-function math below). What that analysis missed: R5 and R6 (10kΩ, at Node B) interact with each other through D1 in a way the simple transfer function doesn't capture. Because C4 blocks DC entirely, Node A's *average* voltage is forced to self-adjust — D1 only draws current on the AC signal's positive peaks, and since a capacitor can't sustain net DC current, that peak current has to be exactly balanced by current flowing the other way through R5. The result is that Node A's average sits well *below* 0V (not centred on it, as the original "peak − Vf" shortcut assumed), which eats directly into the peak voltage that actually reaches D1. This is a real, well-known behaviour for this class of circuit (the same self-biasing effect used deliberately in clamper/DC-restorer circuits) — it just wasn't accounted for here originally.

Working through the steady-state balance: with `D1` conducting only briefly near each peak, Node B settles to approximately

```
V_B ≈ (A×H − Vf) / (1 + R5/R6)
```

where `A` is the source peak, `H` is the AC transfer function below, and `Vf` is D1's forward drop. At the original `R5 = 100kΩ`, that `(1 + R5/R6)` term is `(1 + 10) = 11` — meaning **roughly 91% of the signal that reaches Node A never makes it to Node B at all**, regardless of how well C4/R5 pass the AC signal itself. Simulated in Multisim against the confirmed 2.55V peak, this predicted (and then confirmed) Node B settling around **~0.2V** — a fraction of the ADC's usable range, not the ~2.2–2.4V the original math assumed.

**Fix: R5 lowered to 4.7kΩ.** This isn't simply "as low as possible" — there's a genuine trade-off. Lower R5 improves the `(1 + R5/R6)` self-bias factor, but also increases how much R5 attenuates bass frequencies in the transfer function below (R5 needs to stay large relative to C4's impedance for that). Working through several values at the worst-case frequency (20Hz) and the confirmed 2.55V peak, Node B's voltage actually *peaks* around R5 ≈ 5–6kΩ and falls off on both sides — `4.7kΩ` sits within ~1% of that optimum, using the exact `2.2µF` non-polarized C4 already on hand (no new part needed):

```
R5 = 10,000Ω:  self-bias factor = 1/(1+1.00) ≈ 50%   →  V_B(20Hz) ≈ 1.05V
R5 =  4,700Ω:  self-bias factor = 1/(1+0.47) ≈ 68%   →  V_B(20Hz) ≈ 1.15V
R5 =  2,200Ω:  self-bias factor = 1/(1+0.22) ≈ 82%   →  V_B(20Hz) ≈ 0.86V  (worse — bass loss now dominates)
```

**The maths behind the corrected C4/R5 transfer function** (the AC pass-through part of the picture — still correct on its own, just not the whole story):

```
H(f) = R5 / √[(R5 + R_series)² + (1 / (2πfC4))²]
```

where R_series is R3 or R4 (470Ω). At 20Hz (worst case) with `R5 = 4.7kΩ`, `C4 = 2.2µF`:

```
Z_C4(20Hz) = 1 / (2π × 20 × 0.0000022) ≈ 3,617Ω
H(20Hz) = 4,700 / √(5,170² + 3,617²) ≈ 0.74
```

So ~74% of the signal reaches Node A at the worst-case bass frequency (up to ~91% at higher, more typical frequencies, where C4's impedance becomes negligible and the limit is just the R5/R_series resistive divider). Combined with the self-bias factor above, Node B lands around **~1.1–1.15V at the worst case, up to roughly 1.4V for typical midrange/treble content** — a **5x+ improvement** over the original 100kΩ spec, confirmed against the real 2.55V peak in Multisim (both the AC-coupling behaviour and this self-bias effect were validated there before committing to the change).

**D1 upgraded to a BAT85 Schottky diode for production** (testing circuit keeps the 1N4007 it's already validated with). The 1N4007 was originally picked purely for being on hand, not for suiting this job — it's a general-purpose power rectifier, not a signal diode. A Schottky like the BAT85 has a much lower forward voltage (~0.15–0.3V vs. the 1N4007's estimated ~0.3–0.6V at these tiny currents). BAT85 is a standard choice for exactly this kind of low-level envelope-detector duty (it's a textbook part for AM-detector circuits, the same basic task). Cheap, through-hole, easy to hand-solder alongside everything else on the board.

Either diode still clears the 3.3V ADC ceiling with generous margin — that was never actually in question, even before this correction (if anything, the corrected numbers make overvoltage even less of a concern than previously assumed). What BAT85 actually buys is at the *quiet* end: its lower threshold means less signal is needed before D1 conducts at all, so quiet passages register instead of vanishing below the diode's turn-on point — the same reasoning that made C4/R5 worth adding now that the circuit's resting baseline is genuinely near 0V instead of an elevated bias, and now doubly important given how much of the available range this self-bias effect was already eating into.

**Component choice matters for C4 — a first attempt using two polarized electrolytics wired back-to-back failed and stayed failed, even after reseating.** That trick (tying two same-polarity electrolytics together to approximate a non-polarized cap) only works for a signal that's purely symmetric AC with no sustained DC offset — exactly the opposite of what C4 needs to handle here, since blocking a *sustained* DC bias means one of the two caps in that pair ends up under continuous reverse bias, not the brief, symmetric reverse-bias the trick is designed to tolerate. Sustained reverse bias degrades an electrolytic's leakage behaviour over time, which likely explains why the failure was reproducible — it wasn't a wiring fault, it was the wrong kind of capacitor for this specific job. **C4 must be a genuinely non-polarized capacitor** (ceramic or film, not two electrolytics) — no reverse-bias concern at all, regardless of which direction (or whether) a DC bias is present. Not yet re-tested on the bench with a proper non-polarized part — the `v2` PCB is the next point this gets validated, alongside the real radio.

**Note on the `v2` PCB's schematic/BOM:** the EasyEDA design and its BOM export were finalized (and Gerbers submitted) with `R5 = 100kΩ`, before this correction was found. Since R5 is a through-hole part meant to be hand-soldered (already on the "cheap hand-swap, not a re-fab" list alongside R3/R4/C3/C4), this doesn't require a re-fab — solder a `4.7kΩ` resistor in that position instead of `100kΩ` when assembling. The EasyEDA project's own labelling has since been updated to `4.7kΩ` too, so the schematic now matches what's actually built.

**Ground note:** the conditioning circuit's ground must trace back to the RCA tap's own ground/shield connection — not a separate chassis ground point used elsewhere in the car (e.g. the 12V system's ground). Referencing two different chassis points that aren't at exactly the same potential is a classic source of audible ground-loop hum in the actual audio system, not just an LED-behaviour issue.

**Tap method:** bridge off both signal wires and the ground in parallel at the radio's RCA harness. Never cut into the cable and route the circuit in series — that would interrupt the original signal to the amplifier.

### Pinout — testing board (spare ESP32-C3 module)

Used for bench testing only — a separate, spare ESP32-C3 module, not the one installed in the car.

| Pin/net | Connects to | Purpose |
|---|---|---|
| `GPIO1` | Conditioning circuit output (Node B) | ADC audio input — ADC1_CH1, same pin the production board uses |
| `GPIO7` | Level shifter input → LED strip `DIN` | LED data output — free, non-strapping pin; confirm against your specific board's silkscreen |
| `5V` / `VIN` | LED strip `5V` power input, and the level shifter's own supply | Power — see note* |
| `GND` | Conditioning circuit ground, LED strip `GND`, ESP32-C3 `GND`, level shifter `GND` | Common ground — all must share this one reference |

*The strip is powered at its rated 5V here (most ESP32-C3 modules break out a separate `5V`/`VIN` pin). A level shifter now sits between `GPIO7` and the strip's `DIN`, converting the ESP32-C3's 3.3V data logic up to a clean 5V signal — the same role the production board's SN74AHCT125N plays — so the bench setup no longer has the "3.3V logic driving a 5V strip directly" risk it started with, and now matches the production power/logic arrangement more closely than the original bench-only 3.3V workaround did.

### Pinout — production board (ESP32-C3, new PCB revision)

| Pin/net | Connects to | Purpose |
|---|---|---|
| `GPIO1` | Conditioning circuit output (Node B), routed directly on the new PCB | ADC audio input — **new addition**, currently free |
| `LEFT_LED_PIN` / `RIGHT_LED_PIN` | Existing LED strips | **Unchanged** — reuses the current output path, no new strip or data pin |
| `GND` (existing board net) | Conditioning circuit ground — **which must trace to the RCA tap's own ground/shield**, tied into the board's single shared ground plane, and is R6's return path (the discharge/bias resistor) | Common ground — see Ground note above |

The audio circuit is now part of the same PCB as everything else — R3, R4, R5, R6, C3, C4, and D1 sit alongside the existing components, with a new **JST-XH connector (`J7`)** for the RCA input (matching the J2–J5 style and 2.54mm pitch already used for the LED outputs, MPU6050, and encoder — `J6` was the now-removed switch connector, see below). No `3V3` connection is needed for the conditioning circuit itself — the old bias pull-up resistor was dropped from the design (see the component list note above), so nothing in this circuit draws from the 3.3V rail. Nothing about the LED strips, level shifter, encoder, or accelerometer changes.

**`J6_SWITCH` removed.** `v1`'s BOM includes a 2-pin switch connector that was never actually populated — the physical toggle switch didn't fit, so that connector is currently just shorted instead (see `README.md`). Dropped entirely for `v2` rather than carried forward unused.

---

## Phase 1: GitHub setup — Complete

The repo scaffolding is done: this plan document and its images are committed at `docs/audio-reactive-led-plan.md`, the bench-test sketch exists at `firmware/tests/04_audio_reactive_test/`, `hardware/audio-breakout.md` documents the conditioning circuit, and a new build log section tracks this as a separate addition on top of the completed core project. The v2.x firmware line was left untouched throughout.

**Note:** `hardware/audio-breakout.md`'s content will need revisiting once Phase 3 begins, since it currently describes a standalone breakout board — Phase 3 below has since changed to a full PCB integration instead.

---

## Phase 2: Build and bench-test

Using a spare ESP32-C3 module and the real addressable LED strip found for testing — **the ESP32-C3 installed in the car is not touched during this phase**, avoiding any risk to the already-working, installed v2.4.1 firmware. (Originally planned around a full ESP32 dev board — see the "Testing board update" note above for why a spare ESP32-C3 module is used instead.)

**Stage A — initial tuning, laptop/phone audio (the only validation available before Phase 3): validated, working.**
- [x] Breadboard the conditioning circuit using the component list above
- [x] Wire audio output to `GPIO1`, LED data to `GPIO7` (or confirmed equivalents)
- [x] Flash the Phase 1 test sketch — since rewritten as a bar-graph audio visualizer (growing/shrinking LED bar with a bouncing peak-hold marker, fast attack/slow release) rather than uniform whole-strip brightness; see `firmware/tests/04_audio_reactive_test/`
- [x] Feed it laptop/phone headphone audio (line-level output, good first stand-in for the radio) — via a USB-C-to-3.5mm dongle; the laptop's built-in 3.5mm jack was tried and found too quiet even at max volume, reverted to the dongle
- [x] Tune R1 and C1 (smoothing) by watching how the LED actually responds — confirmed working with R1 at 470Ω, C1 unchanged at 2.2µF; `audioFloor`/`audioCeiling` calibrated from real Serial readings to `900`/`1300` (idle settled ~950, loud peaks ~1200)

**Known issue, not yet fixed:** the small USB-C-to-3.5mm dongle's audio occasionally distorts/corrupts mid-playback, recovering temporarily after unplugging and reconnecting it. Most likely cause: the monitoring speaker (8Ω) is a much lower-impedance load than the dongle's tiny onboard amp is rated to drive continuously, causing it to overload/distort over time. Since the speaker taps the same raw wire the conditioning circuit reads from, this could affect the LED response too during those moments, not just the audible sound. Left unaddressed for now since it hasn't blocked validation; a series resistor (~47–100Ω) between the source and the speaker, or swapping to a powered/amplified speaker, would fix it if it becomes a problem.

**Real-radio validation moved to Phase 3.** The car's actual RCA wiring isn't practically accessible without opening up the already-installed system — not worth the risk to a working install just to bench-test. Two consequences, both accepted:

- **The head unit's actual preamp output voltage is now confirmed.** The Kenwood DPX-07MD's own service manual (`仕様一覧` / specifications page) lists `プリアウトレベル (FM): 1.8V/10kΩ` — a rated preout of 1.8V RMS (~2.55V peak), well inside what was previously assumed (~2–4V RMS). Switching the head unit's internal amp off (already done here, since an external amp is used) doesn't affect this — RCA preamp outs are a separate signal path from the internal amp regardless of that setting. See the confirmed-voltage note above for what this means for ADC-protection margin now that there's no dedicated divider.
- **R1 and C1 should still be tuned by ear/Serial-monitor on the bench.** Watch how loud laptop content lands on the ADC's range and adjust `audioFloor`/`audioCeiling` in firmware to match what you actually see, rather than trusting the placeholder 200/3000 defaults — the confirmed spec means overshoot/clipping risk is low, but the real radio's exact levels can still differ from a laptop's. See Phase 4 for validating this in the car once the new board is installed.

- [x] **Record the working component values and firmware `audioFloor`/`audioCeiling` from Stage A** — R1 = 470Ω, R3/R4 removed, C1 = 2.2µF unchanged, `audioFloor` = 900, `audioCeiling` = 1300; carries into Phase 3 as a starting point, not a final answer

---

## Phase 3: Remanufacture the PCB and develop the firmware

Decided against a standalone breakout board — the audio conditioning circuit will instead be added directly to a new PCB revision, following the same EasyEDA → JLCPCB process already used for the original board (including its GPIO4-fault replacement revision). Firmware development happens in this phase too, once the board's been ordered — no need to wait idle for manufacturing/shipping when the new mode can be written and bench-tested against Phase 2's logic in parallel.

**Parts sourced and in hand** (everything else needed was already on hand from Phase 2 bench testing or the original `v1` build):
- Coupling capacitor (`C4` on the real board) — genuinely **non-polarized** (ceramic or film, not electrolytic), ~2.2–4.7µF, 16V+ rating. **Received.**
- JST-XH 3-pin connector set (male PCB header + female housing + crimp pins), 2.54mm pitch, matching the J2–J5 connectors already on the board — for `J7`, carrying Front Left, Front Right, and shield/ground from the RCA tap. **Received.**
- D1 — a **BAT85** Schottky diode, replacing the 1N4007 for production — see the diode note above. **Received.**

The EasyEDA schematic/layout is designed and verified; the board was ordered from JLCPCB (Global Standard Direct Line shipping) and has now arrived, visually inspected (bare-board photos taken), assembly not yet started. See [docs/multisim-simulation.md](multisim-simulation.md) for the Multisim work behind the R5 correction below. The `v4.0` firmware (below) has been drafted in parallel and compiles clean, though it hasn't been bench-tested yet — the conditioning circuit parts are with the board rather than available on the bench.

- [x] Clone the `v1` EasyEDA project rather than editing it in place — keeps the original, still-installed board's design intact
- [x] Remove `J6_SWITCH` — never populated on `v1` (shorted instead of a real switch), no reason to carry it forward
- [x] Add `R3`, `R4`, `R5`, `R6`, `C4`, `D1` (BAT85), and `C3` as new components, matching the confirmed values (the old bias pull-up resistor and the old divider, both from the testing-circuit's history, stay dropped from the design — see the component list note above). **Note the renumbering**: `v1` already uses `R1`/`R2` and `C1`/`C2` for other components, so the audio circuit's resistors/caps continue on as `R3`–`R6`/`C3`/`C4` instead — see the note above the production component list for the full mapping.
- [x] Add the new JST-XH connector (`J7`) for the RCA input (Front Left, Front Right, shield/ground), matching the existing J2–J5 connector style already used for the LED outputs, MPU6050, and encoder. Front Left confirmed wired to `R3`, Front Right to `R4`, matching the production component list's Left/Right convention.
- [x] Route the conditioning circuit's output to a free ADC-capable pin — `GPIO1`, per the pinout table above
- [x] Tie the new circuit's ground into the board's existing GND net — no separate ground path needed, since the whole board (and now the audio circuit too) already shares one common ground plane; no 3V3 connection is needed for this circuit
- [x] Run design checks — DRC came back with 0 errors. EasyEDA Standard (the free web editor) has no separate ERC report like KiCad/EasyEDA Pro; schematic connectivity (Node S/A/B topology, GND net, no floating pins or duplicate designators) was instead verified directly against the exported schematic JSON, confirming it matches the documented circuit exactly.
- [x] Submit Gerbers to JLCPCB — **ordered**, JLCPCB Global Standard Direct Line shipping, 8–12 business days quoted
- [x] **Develop the new firmware mode while the board is being manufactured/shipped**: a new version *line* — `v4.0`, branching from the final `v2.4.1` — rather than a `v2.x` point release, to clearly distinguish this audio-reactive addition from the core motion-reactive line (`v2.x`) and the parked gyroscope experiment (`v3.x`). **Drafted** in `firmware/mr2-reactive-leds/v4.0/` — Mode 1 (previously a fixed purple theme) replaced entirely with a bar-graph audio visualizer ported from the bench-test sketch, driving both strips through the existing NeoPixel objects, LED brightness capped by the same `userBrightness` ceiling every other mode uses. Compiles clean against the real ESP32-C3 Super Mini target. **Not yet bench-tested** — the conditioning circuit parts are with the `v2` PCB, not available for a bench rebuild; `audioFloor`/`audioCeiling` are still Phase 2 placeholders needing retuning against the real radio in Phase 4.
- [x] Board arrived from JLCPCB — visually inspected, bare-board front/rear photos taken (same approach as `v1`)
- [ ] Assemble the new board — continuity testing, soldering, power-on testing, same validation approach used for the original PCB and its replacement. This is bench-only electrical sanity-checking (no real radio involved yet); real-radio validation happens during install in Phase 4, not here, to avoid tapping the car's RCA wiring twice (once for an early bench check, again for the permanent install).
- [x] Save the new design files under `hardware/pcb/v2/` (gerbers/, bom/, easyeda/), matching the structure the original board's files already use under `hardware/pcb/v1/` — see the note in `hardware/README.md` on the versioned PCB folder layout. `v1`'s `easyeda/` folder was also retroactively completed with its own schematic JSON export, which had been missing.

---

## Phase 4: Install and test

- [ ] Install the new PCB revision in the control box, replacing the currently-installed board
- [ ] Tap Front Left + Front Right RCA, plus ground/shield, in parallel at the radio harness (see Ground note above) — wire everything up before testing anything
- [ ] **Confirm the radio/speaker system still works normally** — the RCA tap is a parallel bridge, never cut in series, but verify nothing about the original audio system broke before moving on
- [ ] **Confirm the original accelerometer-reactive system still works** — motion-based brightness/colour, rotary encoder, both LED strips — exactly as it did on `v1`, before layering the new audio behaviour on top
- [ ] **First real validation against the actual car radio happens here** — this is the earliest point real RCA access is practical. Confirm the ADC isn't clipping (a maxed-out, unresponsive-to-volume reading is the signature), that the idle baseline actually sits near-zero (confirming C4 is doing its job against whatever the real radio's DC characteristics turn out to be), and that C3's smoothing still feels right against real music.
- [x] R5 corrected from `100kΩ` to `4.7kΩ` before assembly (found via Multisim simulation — see the C4/R5 maths note above) — solder `4.7kΩ` in that position; the EasyEDA schematic's own label has since been updated to match
- [ ] If R3/R4/R5/C3/C4 need further correction once tested against the real radio, hand-swap those specific parts too — cheap, quick, doesn't require a re-fab, since the values from Stage A were only ever a laptop-derived starting point
- [ ] Flash the `v4.x` firmware developed in Phase 3 and confirm it drives the real strips correctly with the new board installed
- [ ] Test in the car with real music — expect some retuning against real strips, cabin acoustics, and road noise
- [ ] Update `docs/build-log.md` and the firmware changelog with results, including documenting the new PCB revision (matching how the original GPIO4-fault replacement was documented)
