kilian261299/mr2-reactive-leds/hardware/bom/MR2_Reactive_LEDs_System_BOM.xlsx

Sheet: Sheet1
Category | Component | Quantity | Supplier / Source | Purpose | Notes
Controller | ESP32-C3 Super Mini | 1 | Aliexpress | Main microcontroller | Development board
Sensor | MPU6050 / GY-521 | 1 | Aliexpress | Acceleration and G-force sensing | Chassis-mounted
Lighting | WS2812B LED strip | 2 × 1 m | Aliexpress | Reactive interior lighting | Left and right sides
Level Shifting | SN74AHCT125N | 1 | Aliexpress | 3.3 V to 5 V LED data level shifting | 5 V logic supply
Control | KY-040 Rotary Encoder | 1 | Aliexpress | Brightness and lighting mode control | Includes push button
Power | 12 V to 5 V Buck Converter | 1 | Aliexpress | Converts vehicle 12 V supply to regulated 5 V | Unused — replaced with a repurposed USB charger module (see rows below)
Protection | Inline Fuse Holder | 1 | Aliexpress | Protects added vehicle wiring | Installed close to 12 V supply tap
Power | Fuse | 1 | Aliexpress | Overcurrent protection | 15A
Power Connection | 2-pin Waterproof Automotive Connector | 1 pair | Amazon | Removable 12 V connection to buck converter | Wire-to-wire connection
Switching | Gebildet Metal Toggle Switch | 1 | Amazon | Main system power switch | N/A
Connectors | JST-XH 2.54 mm Connector Kit | 1 kit | Aliexpress | Removable PCB connections | Sensors, encoder and LED connections
Wire | 18 AWG Red/Black Automotive Wire | As required | Aliexpress | 12 V and high-current power wiring | Red = positive, black = ground
Wire | 24 AWG Wire | As required | Amazon | Low-current signal wiring | Various colours for identification
PCB | Custom EasyEDA PCB | 1 | JLCPCB | Main circuit board | Custom-designed two-layer PCB
Hardware | VHB Mounting Tape | As required |  | Mounting LED strips and components | Automotive-grade adhesive
Enclosure | Control Box / Project Enclosure | 1 |  | Houses PCB and electronics | Hidden behind centre dash
Capacitor | Decoupling Capacitors | As required |  | Power supply filtering | Mounted on custom PCB
Resistor | 330 Ω Resistor | 2 |  | WS2812B data-line protection | Placed in series with LED data signal
Power | USB Charger Module (repurposed) | 1 | Repurposed — from an existing USB car charger, not purchased new | Converts vehicle 12 V supply to regulated 5 V — replaces the buck converter above | Disassembled from its housing, mounted in control box; confirmed clean ~5.2 V output via bench testing after the buck converter caused intermittent cold-boot failures
Protection | Schottky Diode (e.g. 1N5822, 3A) | 1 | Not purchased — decided not to pursue | Blocks reverse current from backfeeding onto the shared lighter/radio circuit via USB | Would fix a known minor USB-power backfeed issue, but impact judged too small to be worth it — see build log

Sheet: Audio Addition
Category | Component | Quantity | Supplier / Source | Purpose | Notes
Resistor | 470 Ω Resistor (R3, R4) | 2 | Already on hand | RCA channel isolation (Front Left / Front Right) into the audio conditioning circuit | Bench-validated value; protects source, not used for attenuation
Resistor | 4.7 kΩ Resistor (R5) | 1 | Already on hand | Reference-to-ground resistor for the coupling capacitor (C4) | Corrected from 100kΩ via Multisim simulation (self-bias effect found after Gerbers submitted) — see docs/audio-reactive-led-plan.md. Solder 4.7kΩ, not the 100kΩ shown on the v2 schematic.
Resistor | 10 kΩ Resistor (R6) | 1 | Already on hand | Envelope discharge resistor, Node B to GND | Same role as the testing circuit's R6
Capacitor | 2.2µF Capacitor (C3) | 1 | Already on hand | Envelope smoothing capacitor, Node B to GND | Same role as the testing circuit's C1
Capacitor | Non-polarized Coupling Capacitor (C4) | 1 | Ordered | DC-blocking coupling capacitor ahead of the envelope detector | Must be genuinely non-polarized (ceramic or film, not electrolytic), ~2.2–4.7µF, 16V+ — see docs/audio-reactive-led-plan.md
Diode | BAT85 Schottky Diode (D1) | 1 | Ordered | Envelope detector rectifying diode | Production upgrade from the testing circuit's 1N4007 — lower forward voltage improves quiet-passage sensitivity
Connectors | JST-XH 2.54mm 3-pin Connector (J7) | 1 | Ordered | RCA tap input connector (Front Left, Front Right, shield/ground) | Matches the existing J2–J5 connector style already on the board
