kilian261299/mr2-reactive-leds/images/installation/installation_1.jpeg

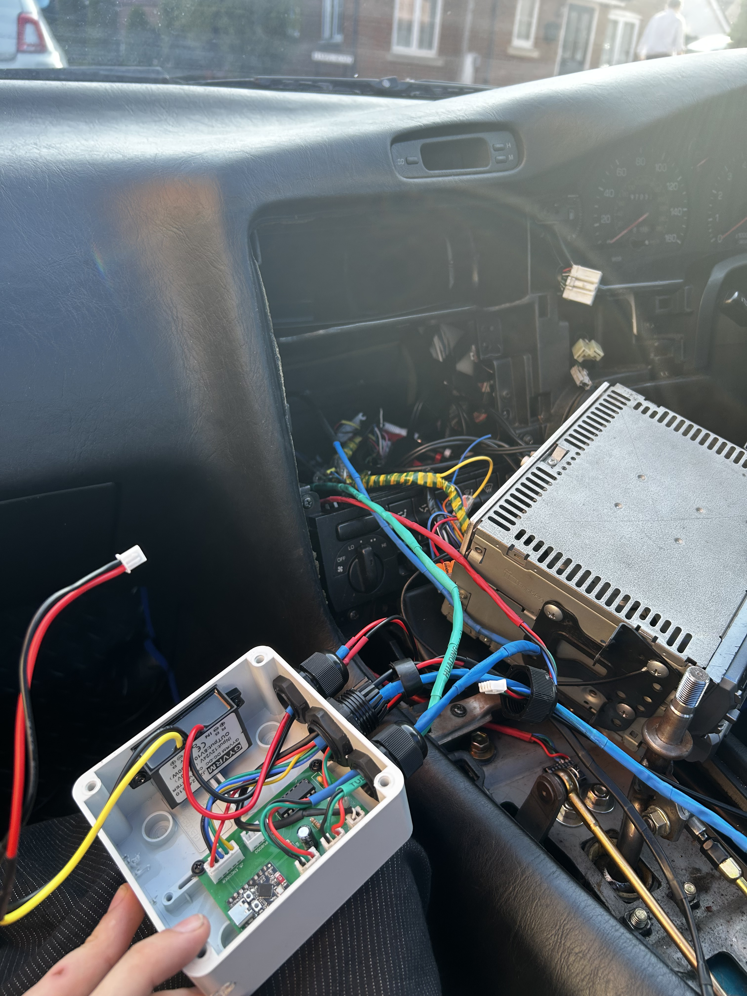
images/installation/installation_1.jpeg
