kilian261299/mr2-reactive-leds/images/audio-circuit/testing_circuit_schematic_original.png

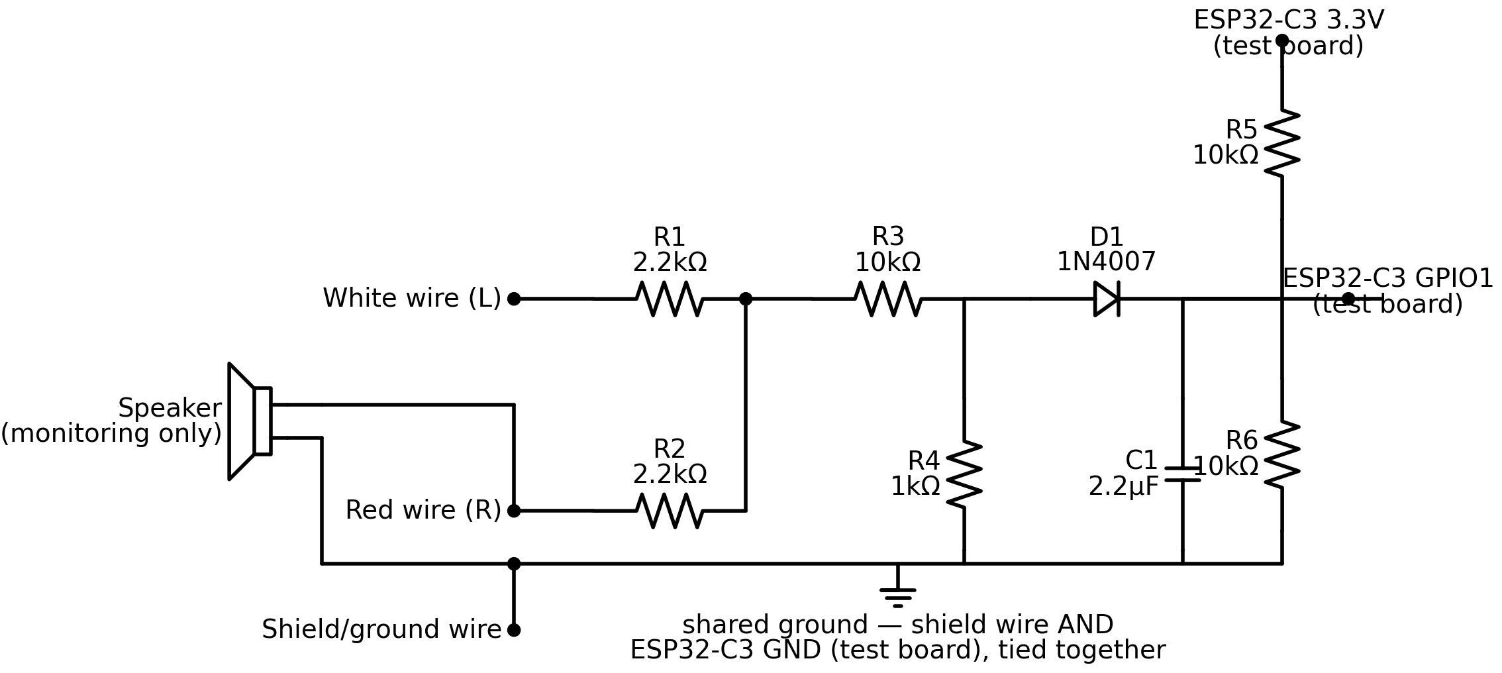
images/audio-circuit/testing_circuit_schematic_original.png
