kilian261299/mr2-reactive-leds/(list of files, drawings)

Other design files:
hardware/pcb/v1/easyeda/PCB_PCB_MR2-reactive-led-system_2026-07-16.json
hardware/pcb/v1/easyeda/SCH_MR2-reactive-led-system_2026-09-17.json
hardware/pcb/v2/easyeda/PCB_PCB_MR2-reactive-led-system-with-audio-input_2026-09-17.json
hardware/pcb/v2/easyeda/PCB_PCB_MR2-reactive-led-system-with-audio-input_2026-09-23.json
hardware/pcb/v2/easyeda/SCH_MR2-reactive-led-system-new-audio-system_2026-09-23.json
