kilian261299/mr2-reactive-leds/(commit log)

2026-07-08 Reorganise build log stages
2026-07-16 Create pcb
2026-07-22 add pcb pictures
2026-07-28 Add v2.1 firmware: field-tuned acceleration response
    Release v2.1, a field-tuning branch of v2.0 based on real driving data. Two test drives (v3.0 and v2.0) were conducted; v2.0 worked well across hills, braking, and cornering, while v3.0 showed unresolved pitch drift during acceleration that needs isolated testing on confirmed-flat ground.
    Development focus shifted to tuning v2.0 rather than continuing v3.0 immediately. Primary change: `accelerationResponseG` lowered from 0.35 to 0.18, based on logged data showing hard acceleration peaking around 0.17g — the old value meant acceleration rarely reached true orange.
    v3.0 is not abandoned; this is a provisional decision pending clarificati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
    [mr2_final_v2_1.ino]
2026-07-28 Set LED counts to 80 in v2.1 and update docs
    Change NUM_LEDS_LEFT/NUM_LEDS_RIGHT from 160 to 80 in the v2.1 firmware (mr2_final_v2_1.ino). Update firmware README and docs/build-log to record the LED-strip cut, note that the v3.0 LED-count fix was carried over to v2.1, and adjust test/checklist wording to reflect the applied fixes and pending serial test drive.
    [mr2_final_v2_1.ino]
2026-08-06 Document power-module swap and add v2.2 notes
    Update docs and firmware metadata to reflect replacing the originally specified 12V→5V buck converter with a repurposed USB charger module (installed and running from the cigarette-lighter circuit). Describe discovered USB-power backfeed issue and recommend a Schottky blocking diode (not yet installed). Add/expand build-log, wiring-plan, and top-level README details about vehicle power, testing status, and known issues. Add v2.2 firmware entry (milder acceleration-hold tuning, built but not yet tested) and update v2.1 status to a confirmed working baseline. Minor .ino headers updated and BOM spreadsheet revised to match.
    [MR2_Reactive_LEDs_System_BOM.xlsx]
2026-08-06 Update docs to reflect final installation and decisions
    Update README, build log, wiring plan and BOM to reflect that the control box, MPU6050, rotary encoder and LED strips are permanently installed in the MR2. Clarifies that only firmware tuning (v2.2 and beyond) remains. Documents the decision to accept (not fix) the USB-power backfeed and the minor speaker noise, and notes the removed master switch and replacement of the specified buck converter with a repurposed USB charger module. Hardware BOM spreadsheet updated to match the current build.
    [MR2_Reactive_LEDs_System_BOM.xlsx]
2026-08-06 Docs: mark cold-boot power fix as confirmed
    Update docs/build-log.md to reflect that the replacement USB charger module has passed repeated cold-boot testing on vehicle power and reliably fixed the intermittent boot failures. Removed now-redundant checklist items requesting further cold-boot tests and adjusted status wording in Stage 8/installation notes to indicate the issue is resolved. Minor wording clarity improvements only.
2026-08-07 Add CLAUDE.md project status summary
    Add CLAUDE.md containing a concise project status for MR2 Reactive LEDs. Documents hardware/install state, resolved hardware issues, known trade-offs, firmware branches (v2.1 baseline, v2.2 pending drive-test, v3.x parked), and open work items (flash/drive-test v2.2, verify encoder/LEDs, decide on v3 testing). Includes links to key docs for build log, firmware README, and wiring plan.
2026-08-07 Docs: confirm rotary encoder brightness and LED output at install
    Both were verified working in the car during the control box's
    initial installation, not left as a separate open item.
2026-08-14 Add v2.3 firmware: lower acceleration threshold for higher gears
    First real-world drive on v2.2 confirms it works well overall
    (mainly 1st/2nd gear) but surfaced two issues: higher gears rarely
    reach true orange, since accelerationResponseG (0.18) was set from
    a single logged 1st-gear peak; and steep downhill sections
    over-trigger braking beyond actual pedal input.
    v2.3 lowers accelerationResponseG to 0.12 (0.18 -> 0.12) as a
    physics-based estimate rather than measured data, since the board
    now runs permanently on vehicle power and USB logging is no longer
    possible. The steep-downhill-braking issue is documented as an
    accepted limitation of the accelerometer-only v2.x line, not fixed
    here.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
    [mr2_final_v2_3.ino]
2026-08-18 Fix v2.3 firmware: code review findings
    Applied fixes from a code review of the new v2.3 file: unified the
    duplicated intensity-curve math (accel/brake/cornering/theme) into a
    shared squareRatio() helper with a divide-by-zero floor; fixed theme
    modes (1-4) using a hardcoded 0.50g threshold instead of tracking
    accelerationResponseG, which had silently decoupled them from three
    rounds of acceleration tuning; guarded recalibration against running
    while the car is moving instead of silently baking a bad baseline;
    removed dead/unreachable code (unused threshold constants, an
    unreachable SETTLING re-entry check); cached last-written LED colour
    per strip to skip redundant rewrites; removed a redund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
    [mr2_final_v2_3.ino]
2026-08-18 Docs: document v2.3 code review fixes
    Update CLAUDE.md, build log, and firmware changelogs to describe the
    code-review pass applied to v2.3 before its first drive test, and
    flag the one real behaviour change to watch for: Modes 1-4 had
    silently stopped reacting to movement (a hardcoded threshold never
    updated across three rounds of acceleration tuning) and are now
    fixed to track accelerationResponseG like Mode 0 does.
    [mr2_final_v2_3.ino]
2026-08-23 Docs: confirm v2.3 as final firmware, mark project complete
    v2.3 drive-tested and confirmed working well: higher gears reach
    orange, Modes 1-4 confirmed noticeably livelier from the code-review
    fix. One known limitation remains and is accepted rather than
    pursued further: steep downhill braking over-triggers on very steep
    hills (confirmed on Brighton hills), a structural limit of the
    accelerometer-only approach. v3.0/v3.1's gyroscope branch is parked
    and not being pursued further, since v2.3 reached a good enough
    result to finish the project.
    Updates CLAUDE.md, README.md, build log, and firmware changelogs to
    reflect project completion.
2026-08-28 Add v2.4 firmware: fix downhill red/blue flicker
    v2.3's first drive worked "almost perfectly" but surfaced a new
    issue not present on earlier versions: flickering between red and
    blue while going downhill, with no braking input needed.
    Traced to v2.1 -> v2.2 (not v2.3's own changes): v2.2 slowed
    gravitySmoothing and made baselineDynamicReentryThreshold more
    sensitive, both to stop sustained acceleration fading too early.
    But gravitySmoothing also governs how fast a downhill grade gets
    absorbed into the baseline, so the acceleration fix quietly slowed
    hill recognition too, and made the state machine easier to
    re-trigger before it settled -- together, a freeze/partial-catch-up/
    re-trigger cyc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
2026-09-13 Add v2.4.1 firmware: fix downhill flicker on gravityZ too
    v2.4's drive test found the direction-aware gravitySmoothing fix
    (forward axis only) made no noticeable difference: downhill flicker
    unchanged, uphill and flat unchanged (both already fine).
    Root cause: a hill pitch shifts gravity on both the forward axis (X)
    and the vertical axis (Z) at once, since both are involved in the
    same rotation. v2.4 only made gravityX direction-aware; gravityZ
    stayed on the old, slow gravitySmoothing rate. Since the state
    machine's gating signal (dynamicMovementG) combines all three axes
    into one magnitude, Z's slow recovery kept that combined signal
    elevated for the old duration regardless of how fast X a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
    [mr2_final_v2_4_1.ino]
2026-09-13 Docs: update all docs to reflect v2.4 test failure and v2.4.1 fix
    v2.4 was drive-tested and found to make no difference to the
    downhill flicker -- it only made the forward axis (gravityX)
    direction-aware, but a hill pitch also shifts the vertical axis
    (gravityZ) at the same time, and the state machine's gating signal
    combines all three axes, so gravityZ's unchanged slow rate kept it
    elevated regardless.
    All docs (CLAUDE.md, README.md, build log, both firmware changelogs)
    now describe v2.4 as a superseded first attempt and v2.4.1 (extends
    the fix to gravityZ) as the current final firmware version, awaiting
    its first drive.
2026-09-14 Add audio-reactive LED feature build plan
    Documents a new, optional mode layered on top of the completed core
    project: LEDs react to music from the car radio via an RCA tap,
    conditioning circuit, and ADC input. Covers circuit design (testing
    and production), pinouts, and a four-phase build plan from bench
    test through firmware integration. Does not touch the existing v2.x
    firmware line.
    The four referenced circuit images (images/audio-circuit/) are not
    yet included -- to be added once available.
2026-09-14 Add Test 4: audio-reactive LED bench-test sketch
    New bench-only sketch for a full ESP32 dev board (not the
    ESP32-C3 installed in the car): reads the audio conditioning
    circuit's envelope on an ADC pin, smooths it with the same
    exponential-filter approach used throughout the main firmware, and
    maps it to LED brightness on a single test strip. Prints raw and
    smoothed values over Serial to support tuning the conditioning
    circuit's divider and smoothing cap during Phase 2 bench testing.
    Does not touch the production firmware or the MPU6050/encoder test
    sketches.
2026-09-14 Add audio conditioning circuit hardware documentation
    Documents the mono-summed RCA tap, resistor divider, diode
    rectifier, smoothing capacitor, and bias network that convert the
    car radio's line-level audio into a 0-3.3V envelope for the ESP32
    ADC. Covers both the bench-testing circuit (phone audio, full ESP32
    dev board) and the production circuit (real RCA tap, ESP32-C3).
    Component values are placeholders pending Phase 2 bench-test
    confirmation -- marked clearly and tracked in an Open Items list.
2026-09-14 Build log: add Audio-Reactive LED Feature section, Phase 1 complete
    Adds a new, clearly-separated top-level section tracking the
    audio-reactive LED feature as an optional addition on top of the
    completed core project (Stages 1-9, v2.4.1) -- not a continuation of
    it. Records Phase 1 (GitHub setup) as complete: plan doc, bench-test
    sketch, and hardware doc all committed; flags the four circuit
    images as a known gap to fill in once available.
2026-09-14 Add audio-circuit images for the audio-reactive LED plan
    Adds the four circuit images referenced by docs/audio-reactive-led-plan.md:
    testing/production setup overviews and schematics. Closes the image
    gap flagged when the plan doc was first committed.
2026-09-14 Plan: use 1N4007 for D1, match testing circuit to production
    Two design updates based on what's actually on hand and how the
    bench setup evolved:
    - D1 changed from 1N4148 to 1N4007 (a general-purpose power
    rectifier, slower-switching than a dedicated signal diode --
    explained in the plan why that's not a problem here, since C1's
    smoothing already makes this a hundreds-of-milliseconds envelope,
    not an audio-frequency signal path).
    - Testing circuit now sums stereo L/R via R1/R2 from the phone's
    3.5mm jack, matching the production circuit's topology, rather
    than using one channel only.
2026-09-14 Hardware doc: match D1 (1N4007) and stereo testing circuit to plan
    Brings hardware/audio-breakout.md in line with the plan doc updates:
    D1 changed from 1N4148 to 1N4007 in both circuits, with the same
    diode-choice rationale added; testing circuit now sums stereo L/R
    via R1/R2 (matching the production topology) instead of a single
    mono channel. Also embeds the now-available schematic images
    directly in this doc.
2026-09-14 Build log: close out image gap, note D1/testing-circuit updates
    The four circuit images are now in the repo, closing the gap flagged
    when Phase 1 was first logged. Also records the post-commit design
    changes: D1 switched to 1N4007, and the testing circuit now mirrors
    production's stereo L/R summing via R1/R2.
2026-09-14 Fix broken image links in audio-reactive-led-plan.md
    The plan doc lives in docs/, so its image references needed
    ../images/audio-circuit/... to reach the repo-root images folder,
    not the bare images/audio-circuit/... it had (which resolved to a
    nonexistent docs/images/ path). Matches the ../images/ convention
    already used by every other docs/ file that embeds images.
2026-09-14 Reference the audio-reactive LED addition across top-level docs
    Adds the new, in-progress audio-reactive LED feature to the docs
    that summarize overall project state, so it's discoverable without
    already knowing to look in docs/audio-reactive-led-plan.md:
    - README.md: new Project Status paragraph and in-progress phase
    checklist, plus Documentation section links
    - CLAUDE.md: new section covering the addition's status and the
    post-plan design updates (1N4007, stereo testing circuit)
    - firmware/README.md: 04_audio_reactive_test added to the folder
    structure and test-sketch listing
    - hardware/README.md: pointer to the new audio-breakout.md
    All clearly marked as a separate, in-progress ad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
2026-09-14 Test 4: use a dark cyan-blue colour instead of plain cyan
    Swaps the test colour from (0, 200, 200) to (0, 90, 160) -- more
    blue-leaning and capped well under 255, so it reads as a deep
    cyan-blue rather than a bright neon cyan, as requested for the
    first real bench test of the built conditioning circuit.
    [MR2_Reactive_LEDs_Test_4.ino]
2026-09-14 Test 4: switch to spare ESP32-C3 module, GPIO1/GPIO7
    Testing board changed from a generic full ESP32 dev board to a
    spare ESP32-C3 module. GPIO34 doesn't exist on the C3, so:
    - AUDIO_PIN: 34 -> 1 (ADC1_CH1) -- same pin the production board
    already uses, so Phase 2 tuning carries straight into Phase 4
    with no remapping needed.
    - LED_PIN: 5 -> 7 -- free, non-strapping pin, arbitrary choice
    since this spare board shares a bus with nothing else.
    Comments and Serial messages updated to match. No logic changes.
    [MR2_Reactive_LEDs_Test_4.ino]
2026-09-14 Docs: reflect testing-board swap to spare ESP32-C3 module
    Updates every doc that referenced the original full-ESP32-dev-board
    testing plan (plan doc, hardware doc, build log, CLAUDE.md,
    firmware/README.md) to describe the spare ESP32-C3 module now used
    instead: GPIO1 for audio (matches production exactly), GPIO7 for
    LED data, and the testing/production circuits are now topologically
    identical since the L/R summing change from the last update.
    Also expands the 3.3V-vs-5V LED power trade-off (data-line logic
    match vs. rated LED voltage) directly into the plan doc and
    hardware doc, where it's actually needed, rather than leaving it
    only in chat history.
    Flags the two testing-specific circuit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
2026-09-14 Update testing-circuit images for the spare ESP32-C3 module
    Replaces the two testing-specific images with versions reflecting
    the GPIO1/GPIO7 pin change and the spare ESP32-C3 module (was
    GPIO34/GPIO5 on a generic ESP32 dev board). Also relabels the audio
    input as a 3.5mm breakout cable with White(L)/Red(R)/Shield(GND)
    wiring, replacing the earlier phone-headphone-jack framing.
    Production images are unchanged.
2026-09-14 Docs: close out testing-image gap, match new wire-colour labelling
    The two testing-specific circuit images are now current (GPIO1/
    GPIO7, ESP32-C3 test board), so removes the "out of date" flags in
    the plan doc and hardware doc. Also updates the surrounding text to
    match the images' new audio-input description: a 3.5mm breakout
    cable with White(L)/Red(R)/Shield(GND) wiring, replacing the earlier
    "phone headphone jack tip/ring/sleeve" framing. Build log and
    CLAUDE.md updated to reflect both changes.
2026-09-16 Docs: confirm v2.4.1 fixed the flicker -- core project complete
    v2.4.1 has been drive-tested: the downhill red/blue flicker is
    gone, and acceleration-hold and braking both feel unchanged from
    v2.2/v2.3. Updates every doc that carried a "built but not yet
    confirmed" caveat (CLAUDE.md, README.md, build log, both firmware
    changelogs) to reflect the confirmed result and mark the core
    reactive-LED project as finished.
    Reframes active project focus as the audio-reactive LED addition,
    now that the core project no longer has open questions.
2026-09-16 Fix image paths in PCB design documentation
    Updated image references for control box documentation.
2026-09-16 Fix broken control box image links in pcb-design.md
    Four images were referenced but only one file actually exists in
    images/control-box/ (control_box.jpeg, .jpg vs .jpeg extension
    mismatch on top of that). Confirmed only one photo was ever taken --
    dropped the three broken references to pcb_mounted.jpg,
    control_box_wiring.jpg, and control_box_complete.jpg, and fixed the
    extension on the one that does exist.
2026-09-16 Restructure hardware/pcb/ into versioned revisions (v1/v2)
    Moves the original PCB's gerbers/bom/easyeda files from
    hardware/pcb/{gerbers,bom,easyeda}/ to hardware/pcb/v1/{...}/, ahead
    of a planned v2 revision that integrates the audio-reactive circuit
    directly onto the board (see docs/audio-reactive-led-plan.md, Phase
    3). Mirrors how firmware versions are already folder-organised.
    Updates docs/pcb-design.md's links and rewrites the stale
    hardware/README.md (which still said "awaiting PCB delivery" long
    after v1 was manufactured, assembled, and installed) to describe
    both the v1 status and the v2 plan.
    No functional change to v1's files -- move and doc updates only.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
    [MR2_Reactive_LEDs_PCB_BOM.csv, PCB_PCB_MR2-reactive-led-system_2026-07-16.json]
2026-09-16 Update audio-circuit images: add monitoring speaker, clarify ground
    Testing schematic and setup overview now show a monitoring speaker
    tapped across the R wire and shared ground (not part of the
    conditioning circuit) so audio content can be heard while tuning.
    Production schematic's ground label clarified for readability --
    no functional change.
2026-09-16 Plan: integrate audio circuit into a new PCB revision (v2)
    Replaces the standalone-breakout-board approach with a full PCB
    remanufacture: R1-R6, D1, and C1 join the existing board design,
    alongside a new RCA input connector matching the existing J2-J5
    connector style. Same EasyEDA -> JLCPCB process already used for
    the original board's GPIO4-fault replacement revision.
    Production pinout section updated to describe the new-PCB framing
    instead of a breakout board wired into the existing one. Phase 1's
    "prompt for Claude Code" replaced with a completion summary, now
    that Phase 1 is done and that record lives in git/build-log history
    anyway. Phase 3 rewritten as a PCB design checklist (EasyEDA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
2026-09-16 Docs: reflect PCB-remanufacture decision and v1/v2 hardware structure
    Updates CLAUDE.md, README.md, and the build log's audio-reactive
    section to match the plan doc: Phase 3 is now a PCB remanufacture
    (not a standalone breakout board), hardware/pcb/ files are organised
    by revision, and hardware/audio-breakout.md is flagged as describing
    a now-superseded design (still accurate on the circuit itself).
    Also updates Phase 2's status (in progress -- breadboarded, not yet
    bench-tested) and notes the monitoring speaker added to the testing
    setup, both previously undocumented outside chat.
2026-09-16 Plan: move real-radio validation from Phase 2 to Phase 3
    The car's RCA wiring isn't practically accessible for bench testing
    without opening up the already-installed system -- not worth the
    risk to a working install. Drops Stage B (alligator-clip validation
    on the breadboard) from Phase 2; Stage A (laptop/phone audio) now
    explicitly the only pre-manufacture validation available.
    Documents why this is an acceptable trade-off: R3/R4 should be
    tuned for headroom rather than precision, since the head unit's
    real preamp voltage is unknown (Kenwood DPX-07MD, no confirmed spec
    found; typical car head units run ~2-4V RMS vs a laptop's ~0.3-1V),
    and overshooting the ADC's ceiling clips unrecoverably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
2026-09-16 Circuit fix: drop R5, fixing a bias-point incompatibility with D1
    Numeric trace through the circuit and firmware found the R5/R6 bias
    network (10k/10k) set the envelope's resting voltage at 1.65V, but D1
    only conducts once Node A exceeds that by its own forward drop -
    Node A's realistic peak after the R3/R4 divider is only ~0.14-0.51V,
    4-15x too small. The circuit would never respond to audio.
    R5 removed entirely; R6 alone returns Node B to GND (~0V resting
    point), the standard single-resistor diode-envelope-detector
    topology, so D1 only needs to clear its own ~0.3-0.6V drop instead of
    ~2V+. Updated component lists, pinouts, and Phase 3 checklist across
    the plan and hardware docs accordingl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
2026-09-16 Circuit fix: change R3/R4 to 1k/1k, over-attenuation was the new bottleneck
    With R5 removed (previous commit), D1's conduction threshold dropped
    to just its own forward voltage - but the R3/R4 divider's original
    10k:1k ratio (~11x attenuation, sized as ADC-protection headroom
    against an unconfirmed car-radio voltage) turned out to be more than
    that protection goal needs (~2x is enough) and left even a laptop's
    signal too small to reliably clear D1's threshold.
    R3 changed 10k -> 1k, matching R4. Laptop peaks now land ~0.75V and a
    low car-radio estimate ~1.4V at Node A, both clearing D1 with margin,
    while a worst-case ~5.6V estimate still lands under the ADC's 3.3V
    ceiling. That worst-case vo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
2026-09-16 Refresh audio circuit schematics
    Regenerated the production and test audio circuit schematic images to match the corrected envelope-detector design. This updates the diode biasing and resistor values after confirming the original circuit would not conduct with a realistic audio signal, and reflects the revised bench-test setup.
2026-09-16 Remove outdated warnings from circuit schematics
    Removed outdated warnings about circuit schematics needing updates.
2026-09-17 Confirm car radio preout voltage from Kenwood DPX-07MD service manual
    Replaces the earlier unconfirmed "~2-4V RMS" guess with the actual
    rated spec: the manual's specifications page lists a preout level of
    1.8V RMS into 10k ohms (~2.55V peak). With R3=R4=1k, this puts the
    real radio's worst-case Node A peak at ~1.27V - comfortable margin
    under the ADC's 3.3V ceiling and above D1's conduction threshold, so
    the ADC-protection question for the production circuit is no longer
    a guess (final bench/in-car confirmation in Phase 3 remains good
    practice, not a safety requirement).
2026-09-17 Circuit: remove R3/R4 divider, reduce R1/R2 to 470ohm, confirm findings
    Live bench testing with the R3=R4=1k divider still in place showed no
    response to music at all - the combined attenuation through R2 (2.2k)
    plus the divider left too little signal for D1 to ever conduct. Fixed
    by removing R3/R4 entirely and reducing R1/R2 from 2.2k to 470ohm
    (still enough for channel isolation/short protection, without adding
    unneeded attenuation on top). This is safe for production too: with
    no divider, ADC protection now comes purely from D1's own forward
    drop against the confirmed radio voltage (1.8V RMS/~2.55V peak, from
    the Kenwood DPX-07MD service manual), landing around 1.95-2.25V at
    Node B - comf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
2026-09-17 Test 4: rewrite as a bar-graph audio visualizer, not uniform brightness
    Replaces the whole-strip brightness scaling with a growing/shrinking
    bar of lit LEDs plus a bouncing peak-hold marker (fast attack, slow
    gravity-fall release) - a VU-meter-style visualizer instead of the
    whole strip just dimming and brightening together.
    [MR2_Reactive_LEDs_Test_4.ino]
2026-09-17 Test 4: calibrate audioFloor/audioCeiling to observed bench range
    Set from real Serial readings: idle settled around 950, loud content
    peaked around 1200. Floor/ceiling (900/1300) leave a bit of margin
    either side rather than snugly matching the two observed points.
2026-09-17 Docs: Stage A bench validation confirmed working
    Marks Stage A's checklist complete, records the calibrated
    audioFloor/audioCeiling (900/1300) and final component values, notes
    the firmware's shift from uniform brightness to a bar-graph visualizer
    with peak-hold, and documents the USB-C dongle distortion issue as a
    known, deferred item (likely the monitoring speaker overloading its
    small onboard amp).
2026-09-17 Phase 3 prep: adopt coupling cap (C2/R7), decide JST-XH RCA connector
    C2/R7 (DC-blocking coupling capacitor + reference resistor) formally
    adopted for the v2 PCB after diagnosing why the earlier back-to-back
    electrolytic attempt failed: that trick only tolerates brief AC
    reverse-bias, not the sustained DC offset C2 needs to block, so one
    cap was under continuous reverse bias and degraded - a component
    choice problem, not a wiring fault. C2 must be a genuinely
    non-polarized capacitor (ceramic or film) instead.
    RCA input connector decided: JST-XH 3-pin, matching the board's
    existing connector style.
    Added a "parts to source" list to the plan (non-polarized cap, JST-XH
    connector set) - everyt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
2026-09-17 Update audio circuit setup diagrams
    Refresh the production and bench-test audio circuit overview images to match the latest conditioning circuit layout and setup notes. This keeps the documentation aligned with the current mono/breadboard testing configuration and planned production integration.
2026-09-17 Docs: clarify confusing 3.3V/5V LED power pinout entry
    The pinout table read as "3.3V connects to 5V", which looks like a
    typo/error at a glance even though it's intentional (the strip's
    power input is labelled 5V but deliberately fed 3.3V for logic-level
    matching). Reworded to state that plainly instead of relying on the
    reader to trace it through the footnote.
2026-09-17 Docs: correct testing pinout - strip is powered from 5V, not 3.3V
    The bench setup actually feeds the LED strip from the ESP32-C3's
    5V/VIN pin at its rated voltage, not from 3.3V as previously
    documented. Flipped the framing: 5V is what's actually wired (with
    the data-line logic-level caveat that implies), 3.3V is the
    alternative that would avoid needing a level shifter, not the other
    way around.
2026-09-17 Docs: testing pinout now includes the level shifter added to the bench
    The bench rig now has a level shifter between GPIO7 and the strip's
    DIN, converting 3.3V logic to 5V - the same role the production
    board's SN74AHCT125N plays. Removes the "3.3V logic driving a 5V
    strip directly" caveat that no longer applies, and notes the bench
    setup now matches production's power/logic arrangement more closely.
2026-09-17 Update production schematic to show C2/R7, remove stale warning
    Production circuit schematic redrawn to include the DC-blocking
    coupling capacitor and its bleed resistor. Removed the now-stale
    "out of date" note in hardware/audio-breakout.md pointing at this
    image.
2026-09-17 Docs: D1 upgraded to BAT85 for production, fix stale testing warning
    Removed the incorrect "out of date" warning on the testing schematic -
    it was flagged for lacking C2/R7, but those were only ever a
    production addition (the breadboard attempt failed and was reverted,
    never actually validated), so the testing circuit correctly doesn't
    show them.
    D1 changed from 1N4007 to BAT85 (Schottky) for the production v2
    board only - the testing circuit keeps the 1N4007 it's already
    validated with. The 1N4007 was picked for availability, not suited to
    this job; BAT85's lower forward voltage helps quiet passages register
    more faithfully now that C2 gives a clean near-0V baseline. Added to
    the Phase 3 p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
2026-09-17 Scope designator renumbering to production only, add J7/J6 removal
    Testing circuit reverted back to the simple R1/R2/C1/C2 labels - it's
    breadboard-only and never gets loaded into EasyEDA, so it never
    actually needed to avoid v1's designator collisions. Only the
    production component list (which maps to the real v2 schematic) now
    uses R8/R9/C3/C4, with a note explaining why the two lists
    deliberately use different numbers for the same conceptual parts.
    Also added: J6_SWITCH removal (v1's switch connector was never
    populated, just shorted - dropped for v2), and the new RCA connector
    named J7 rather than reusing J6, to avoid the freed-up number meaning
    something unrelated across board revision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
2026-09-17 Production designators: continuous R3-R6 instead of R8/R9 + R6/R7
    Switched from the gappy R8/R9 (isolation) + R6/R7 (discharge/coupling
    reference) scheme to continuous numbering right after v1's existing
    R1/R2: R3/R4 (isolation), R5 (coupling reference), R6 (discharge).
    Cleaner and avoids an arbitrary-looking jump to R8/R9 on a fresh
    schematic.
    Flagged the one unavoidable side effect: production's new R5 shares
    a digit with "R5" in the testing-circuit's own history (the removed
    bias pull-up resistor) - added a note distinguishing the two rather
    than leaving it ambiguous.
2026-09-17 Docs: fix stale "topologically identical" claim for testing vs production
    Testing and production circuits stopped being identical once C4/R5
    and the D1 diode swap were added to production only. Matches the
    equivalent note already corrected in hardware/audio-breakout.md.
2026-09-17 Archive original pre-R5-removal schematic, link from the removal notes
    The "R5 removed" and "R3/R4 removed" narrative text described a
    circuit no reader could actually see, since the current schematic was
    redrawn without R5/R3/R4 long ago. Recovered the last version showing
    them from git history (commit 1de7985) and saved it as
    testing_circuit_schematic_original.png, linked directly from both
    docs' R5-removal notes so the text has a visual reference again.
2026-09-17 Update production schematic with final designators and BAT85
    Redrawn by user to match the confirmed circuit: R3/R4 (470ohm
    isolation), C4 (coupling cap), R5 (100k reference), D1 (BAT85), C3
    (2.2uF smoothing), R6 (10k discharge).
2026-09-17 Flag stale white=L labeling on the archived original schematic
    The archived pre-R5-removal image labels the white wire as the
    left-channel input, matching the assumption at the time it was drawn
    - but that was later found wrong for this specific cable (white is
    actually a second ground/drain wire, not a real channel). Added a
    caveat next to both docs' links to the archived image so it doesn't
    mislead anyone who opens it.
2026-09-17 Move C4/R5 and D1/BAT85 explanations into the production section
    They were previously described in the testing-circuit section even
    though neither was ever actually part of the validated breadboard
    circuit (the C2/R7 coupling-cap attempt failed and was reverted; the
    BAT85 diode swap was production-only from the start). Moved both
    explanations to where they actually apply, and added the numeric
    transfer-function analysis showing why they barely touch the signal:
    ~99.5% pass-through for C4/R5 even at 20Hz worst-case, and the
    resulting Node B voltage margin for D1 under both diode options.
    Also fixed hardware/audio-breakout.md's testing circuit diagram and
    component table, which still showed C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
2026-09-17 Repo-wide consistency pass: audio circuit ready for Phase 3
    Brought every file referencing the audio-reactive addition up to
    date with decisions made since the last sync - none of these had
    been touched to reflect Stage A completion, the final R3-R6/C3/C4
    production designators, the D1->BAT85 swap, or the J6_SWITCH removal
    / J7 addition:
    - CLAUDE.md: full rewrite of the Audio-Reactive LED section
    - README.md: Phase 2 marked complete/validated, Phase 3 ready to start
    - firmware/README.md: describes the bar-graph visualizer, not the old
    uniform-brightness behavior
    - hardware/README.md: correct v2 component list and designators,
    J6_SWITCH removal noted
    - docs/build-log.md: Phase 3 status s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
2026-09-17 Move confirmed radio voltage note to production section
    Not relevant to the testing circuit, which never involves the actual
    radio - only laptop/phone audio. Matches the same reasoning already
    applied to the C4/R5 and D1/BAT85 notes.
2026-09-17 Remove redundant checklist item, clarify R3/R4 reuse forward-reference
    The "update production schematic with Stage A values" checklist item
    was already done - production list already shows the confirmed
    values with asterisks pending Phase 3. Removed rather than leaving a
    stale unchecked box.
    Added a heads-up where "R3/R4 removed" is first mentioned in both
    docs, since that note appears before the production renumbering note
    that explains those same numbers get reused for unrelated components
    later - without the forward-reference, a reader could think the old
    divider was somehow back.
2026-09-17 Fix backwards logic: real-radio confirmation happens IN Phase 3, not before it
    The old phrasing said to "update with confirmed values before Phase 3
    begins" and "* marks values expected to change once Phase 2 confirms
    real values" - but Phase 2 (laptop/phone bench testing) only ever
    gave a starting point, and the actual real-radio confirmation is
    explicitly what Phase 3 is for. Corrected in both docs: fabricate v2
    with the current bench-confirmed values populated, validate/correct
    against the real radio during Phase 3 on the assembled board (a
    hand-swap, not a re-fab), then remove the * once that's actually
    happened.
2026-09-17 Remove two more stale/redundant items
    "Values are starting points for Phase 2 - expect to retune..." was
    forward-looking language left over from before Stage A was actually
    completed; removed from both docs since that retuning already
    happened and is recorded.
    Removed the Phase 3 checklist item "Confirm the RGB/addressable LED
    and conditioning circuit values from Phase 2" - redundant with the
    already-completed Phase 2 recording, and confusingly worded next to
    the real confirmation-against-hardware step later in the same
    checklist (the actual real-radio validation).
2026-09-17 Move real-radio validation from Phase 3 to Phase 4
    Phase 3 is now PCB fabrication and bench assembly only (visual
    inspection, continuity, power-on - same as v1's original validation,
    no real radio involved). Real-radio validation moves to Phase 4's
    install, avoiding tapping the car's RCA wiring twice - once for an
    early Phase 3 bench check, again for the permanent install.
    Phase 4's testing order is now explicit: confirm the radio/speaker
    system still works after the RCA tap, then confirm the original
    accelerometer-reactive system still works, then validate the new
    audio circuit against real radio, then the firmware integration.
    Updated all four files that referenced the old Phase 3 real-r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
2026-09-17 Fix testing circuit text to match the actual redrawn schematic
    The testing schematic image uses a single R1 (470ohm) directly in
    series with the red wire - no separate R2, no unconnected placeholder
    for a future left channel, and no C2/R7 coupling stage (that was
    always production-only, never validated on the breadboard). The text
    component list, speaker-tap sentence, white-wire note, and component
    role table all still described the old two-resistor/coupling-cap
    version. Retired "R2" as a label from the testing narrative entirely
    (it now only ever refers to v1's real board component, correctly kept
    as "R1/R2" in that context) and rewrote the production-designator
    note to clarify that product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
2026-09-17 Phase 3 status: in progress (not "ready to start"), fix C4 note placement
    Updated Phase 3 status wording across CLAUDE.md, README.md,
    hardware/README.md, and docs/build-log.md - work is actively underway
    (schematics redrawn, parts being sourced), not just "ready to begin."
    Also fixed a narrative gap: the C4/R5 "component choice matters" note
    in the production section describes a failed back-to-back-electrolytics
    experiment, but the testing section never mentioned this was
    attempted at all. Added a brief acknowledgment in both docs' testing
    sections that this was tried and reverted on the breadboard, pointing
    to the production section for the full diagnosis.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
2026-09-17 Remove Phase 4 action from Phase 3's Open Items checklist
    "Replace the *-marked placeholder values with confirmed ones" can't
    actually be done until Phase 4's real-radio validation happens - it
    was listed as a Phase 3 open item, which is misleading since it can
    never be checked off during Phase 3. Already correctly tracked in
    docs/audio-reactive-led-plan.md's Phase 4 checklist; removed the
    duplicate/premature copy here. The status note at the top of this
    file already explains when final confirmation happens.
2026-09-17 Move firmware development into Phase 3, new v4.x version line
    Phase 3 now covers PCB remanufacture AND writing the new firmware
    mode - no reason to wait idle for the board to be manufactured and
    shipped when the firmware can be developed and bench-tested against
    Phase 2's logic in parallel, once Gerbers are submitted.
    Phase 4 renamed "Install and test" - it now flashes and validates the
    already-written v4.x firmware against the real installed hardware,
    rather than writing it from scratch.
    New firmware version line: v4.x, branching from v2.4.1 but as a new
    major version rather than a v2.x point release, to clearly separate
    the audio-reactive addition from the core motion-reactive line (v2.x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
2026-09-17 Test 4: fix LEDs freezing when no Serial Monitor is connected
    The ESP32-C3 uses native USB serial rather than a separate
    USB-to-serial chip. Without a host reading the port, the internal
    buffer eventually fills from the periodic debug prints, and
    Serial.print() starts blocking instead of discarding data - freezing
    the whole loop() (and the LEDs with it) until a monitor connects and
    drains the buffer. Matches exactly with "LEDs only react when the
    Serial Monitor is open."
    Fixed by checking `if (Serial)` before printing, so the block is
    skipped entirely when nothing's listening rather than ever risking
    filling the buffer.
    [MR2_Reactive_LEDs_Test_4.ino]
2026-09-17 Test 4: use availableForWrite() instead of if(Serial) to gate printing
    if (Serial) alone didn't fix the LEDs-freeze-when-monitor-closed bug -
    on some ESP32 core versions that flag reflects "USB cable plugged in"
    rather than "a program is actually reading the port," so it can stay
    true after the monitor closes. Checking Serial.availableForWrite()
    tests actual buffer space instead, which is what really determines
    whether print() would block, regardless of connection-flag accuracy.
    [MR2_Reactive_LEDs_Test_4.ino]
2026-09-17 v2 PCB design complete: audio circuit verified, files committed, parts ordered
    Design cloned from v1 in EasyEDA, R3-R6/C3/C4/D1(BAT85)/J7 added and
    J6_SWITCH removed. DRC clean; connectivity manually verified from the
    exported schematic JSON since EasyEDA Standard has no separate ERC,
    which also caught J7's Front L/R pins wired backwards (R3=Right/R4=Left)
    -- fixed and re-verified as R3=Left/R4=Right, matching the docs.
    Commits the v2 design files (gerbers/bom/easyeda) and retroactively adds
    v1's missing schematic JSON export. Adds a new "Audio Addition" tab to
    the system BOM for the new parts, now marked ordered. Updates docs across
    the repo to reflect Phase 3 status: design done, about to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
    [BOM_MR2-reactive-led-system-new-audio-system_2026-09-17.csv, MR2_Reactive_LEDs_System_BOM.xlsx, PCB_PCB_MR2-reactive-led-system-with-audio-input_2026-09-17.json, SCH_MR2-reactive-led-system-new-audio-system_2026-09-17.json, SCH_MR2-reactive-led-system_2026-09-17.json]
2026-09-17 v2 PCB ordered from JLCPCB
    Gerbers submitted, Global Standard Direct Line shipping (cheapest
    option), 8-12 business days quoted. Marks the last open Phase 3
    checklist item before firmware development. Docs updated across the
    repo to reflect the board is now in fabrication/shipping.
2026-09-17 Test 4: add cyan/orange loudness colour snap with hysteresis
    Bar colour now snaps to orange once the audio level gets loud enough,
    instead of a fixed cyan bar regardless of volume. A single threshold
    caused rapid flicker at the boundary (level naturally jitters on real
    music), which blended cyan/orange into a washed-out white to the eye --
    fixed with separate on/off thresholds (0.7/0.55) so the colour can't
    toggle right at one boundary.
    [MR2_Reactive_LEDs_Test_4.ino]
2026-09-18 Draft v4.0 firmware: audio-reactive Mode 1
    Branches from v2.4.1. Mode 1 (previously a fixed purple theme) is
    replaced entirely by a bar-graph audio visualizer ported from the
    validated bench-test sketch: reads the conditioning circuit's envelope
    on GPIO1, same attack/release smoothing, cyan-to-orange colour snap
    with hysteresis (carrying over the flicker fix found on the bench
    sketch). Bar length tracks volume; LED brightness is a separate thing,
    capped by the same rotary-encoder ceiling every other mode uses, via
    the same scaling math setStrip() already uses elsewhere in the file.
    Modes 0, 2, 3, 4 are untouched.
    Also applies the bench sketch's Serial.availableForWrite() fix to
    v2.4.1's pre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
    [mr2_final_v4_0.ino]
2026-09-23 Correct R5 from 100kOhm to 4.7kOhm: self-bias effect found via Multisim
    The original C4/R5 analysis only modelled the coupling stage as a
    simple AC high-pass filter, which it passes ~99.5% of signal, true
    in isolation -- but missed a self-biasing effect where D1 drawing
    current from Node A only on signal peaks forces Node A's average
    voltage down (since C4 blocks DC, that current has to balance
    against R5), eating into the peak voltage that ever reaches the
    diode. At the original R5=100kOhm this factor works out to ~9%
    utilization; simulated against the confirmed 2.55V real-radio peak,
    Node B settled around ~0.2V, not the ~2.2-2.4V originally assumed
    throughout Phase 3.
    Found and fixed by b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
    [MR2_Reactive_LEDs_System_BOM.xlsx]
2026-09-23 Update production schematic image with corrected R5 value
    Re-exported from EasyEDA showing R5=4.7kOhm (was 100kOhm). Removes
    the stale-image caveat notes added alongside the R5 correction, now
    that the image matches the docs again.
2026-09-23 Re-export v2 EasyEDA schematic/PCB/BOM with corrected R5 value
    R5 updated from 100kOhm to 4.7kOhm in the EasyEDA project itself
    (schematic and BOM confirmed showing 4.7k; PCB layout re-exported
    too for a matched same-session snapshot, though it's unaffected --
    a resistor's value doesn't touch footprint/routing). Gerbers not
    resubmitted since they carry no value information and the board is
    already in fabrication.
    [BOM_MR2-reactive-led-system-new-audio-system_2026-09-17.csv, BOM_MR2-reactive-led-system-new-audio-system_2026-09-23.csv, PCB_PCB_MR2-reactive-led-system-with-audio-input_2026-09-23.json, SCH_MR2-reactive-led-system-new-audio-system_2026-09-17.json, SCH_MR2-reactive-led-system-new-audio-system_2026-09-23.json]
2026-09-28 Update docs for v2 PCB arrival, fix stale hardware/README file tree, add Multisim simulation writeup
    Repo-wide status correction: v2 PCB has arrived from JLCPCB and been
    visually inspected, replacing stale "ordered/in fabrication/shipping"
    language across README.md, CLAUDE.md, hardware/README.md,
    docs/audio-reactive-led-plan.md, hardware/audio-breakout.md, and
    docs/pcb-design.md. Added a corresponding build-log entry.
    hardware/README.md's folder-structure tree was missing hardware/bom/,
    audio-breakout.md, and README.md itself — fixed.
    New docs/multisim-simulation.md documents the Multisim methodology and
    results behind the R5 correction (100kOhm -> 4.7kOhm): AC Sweep setup
    gotchas, the t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
2026-09-28 Reorganize images/pcb into per-revision v1/v2 subfolders, add images/multisim
    Mirrors the existing hardware/pcb/v1, v2 structure. All v1 PCB images
    moved into images/pcb/v1/ (tracked as renames), with images/pcb/v2/ and
    images/multisim/ created ready for the new v2 board photos, EasyEDA
    screenshots, and Multisim simulation screenshots. Updated the image
    references in docs/pcb-design.md and docs/build-log.md accordingly.
2026-09-28 Add v2 PCB photos, EasyEDA renders, and Multisim screenshots
    New v2 section in docs/pcb-design.md mirrors v1's structure: schematic,
    layout, 2D/3D renders, and bare-board photos (front/rear) of the
    arrived board. Flags that the EasyEDA schematic screenshot still shows
    the stale R5=100kOhm label, not yet updated to the corrected 4.7kOhm.
    docs/multisim-simulation.md now includes the actual Multisim schematic
    and oscilloscope screenshots from the AM-modulated transient test
    (blue = input, red = Node B output), replacing the earlier
    hypothetical description with the real result and correcting the
    modulation frequency detail to match (10Hz, not 5Hz).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
2026-09-28 Confirm C4/D1/J7 parts received, ready for v2 assembly
    Kilian confirmed all three previously-ordered parts (non-polarized C4,
    BAT85 D1, JST-XH J7 connector set) have arrived alongside the board.
2026-09-28 Update v2 schematic image with corrected R5 label, close out stale-label notes
    The v2 schematic screenshot at images/pcb/v2/PCB_V2_schematic.png
    hadn't actually changed after the first "fix" attempt (same file size
    and mtime as before) - the EasyEDA project's R5 label wasn't actually
    edited yet. Found the real re-export sitting in Downloads
    (Screenshot 2026-09-29 003738.png, showing R5=4.7k correctly) and
    copied it into place.
    Updated every doc that previously flagged the schematic/EasyEDA label
    as stale (docs/pcb-design.md, docs/audio-reactive-led-plan.md,
    hardware/audio-breakout.md, hardware/README.md, CLAUDE.md) now that it
    matches the physical 4.7kOhm value, and added a build-log entry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
2026-09-28 Consistency pass: fix remaining stale 'Ordered' part status in CLAUDE.md/README.md/hardware/README.md
    Full repo audit before PCB assembly: verified every image link resolves,
    every markdown file/anchor link resolves, R5=4.7kOhm is consistent across
    the BOM xlsx, BOM CSV, EasyEDA schematic JSON, EasyEDA schematic PNG, and
    the audio-circuit schematic diagram, and every Phase 3 checklist item
    across audio-reactive-led-plan.md and hardware/audio-breakout.md tells
    the same story. Only remaining gap was three leftover "Ordered." labels
    for C4/D1/J7 that should have read "Received." - fixed.
