kilian261299/mr2-reactive-leds/images/pcb/v2/pcb_v2_picture_top.jpeg

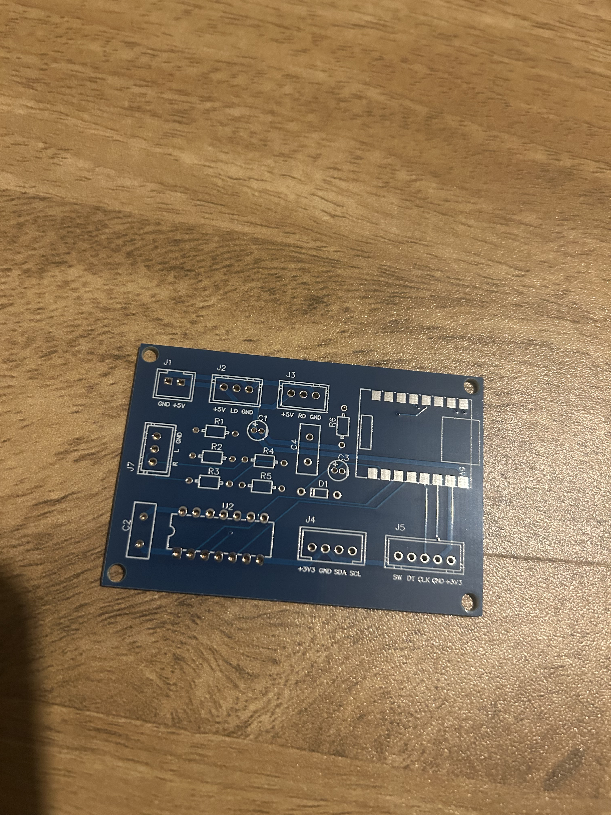
[picture p16: images/pcb/v2/pcb_v2_picture_top.jpeg]
images/pcb/v2/pcb_v2_picture_top.jpeg
