kilian261299/mr2-reactive-leds/images/pcb/v2/pcb_v2_picture_bottom.jpeg

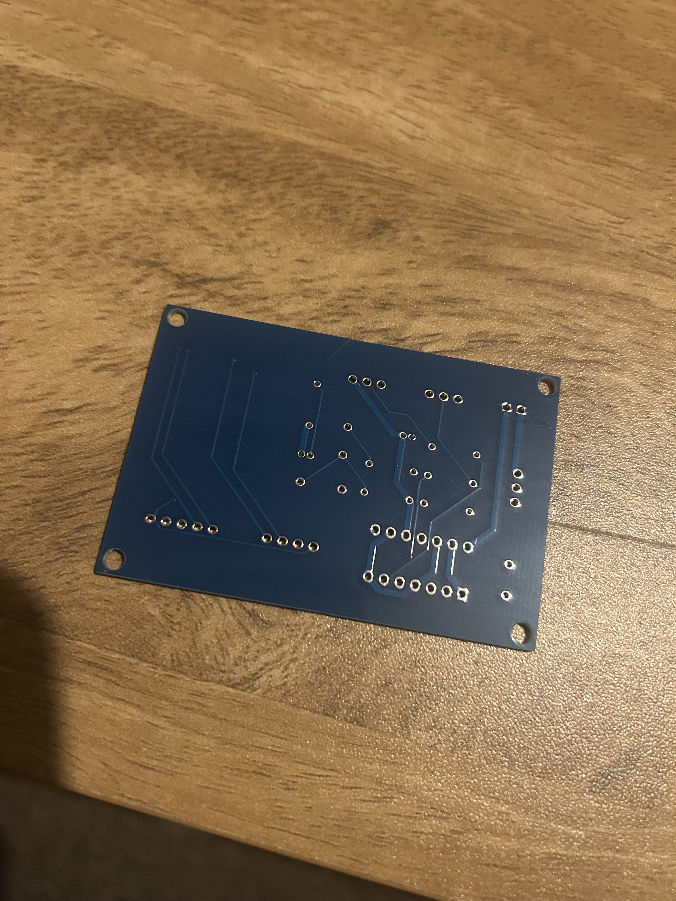
[picture p17: images/pcb/v2/pcb_v2_picture_bottom.jpeg]
images/pcb/v2/pcb_v2_picture_bottom.jpeg
