kilian261299/mr2-reactive-leds/images/breadboard/breadboard_test_3.jpeg

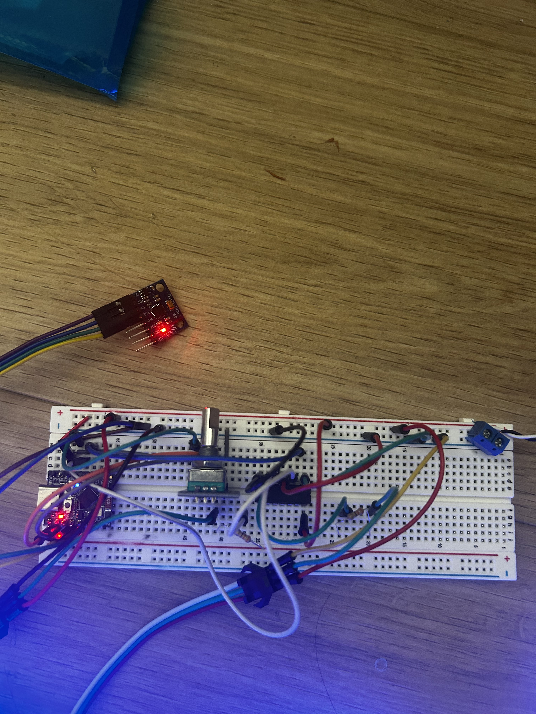
[picture p27: images/breadboard/breadboard_test_3.jpeg]
images/breadboard/breadboard_test_3.jpeg
