kilian261299/mr2-reactive-leds/images/installation/sensor_mount.jpeg

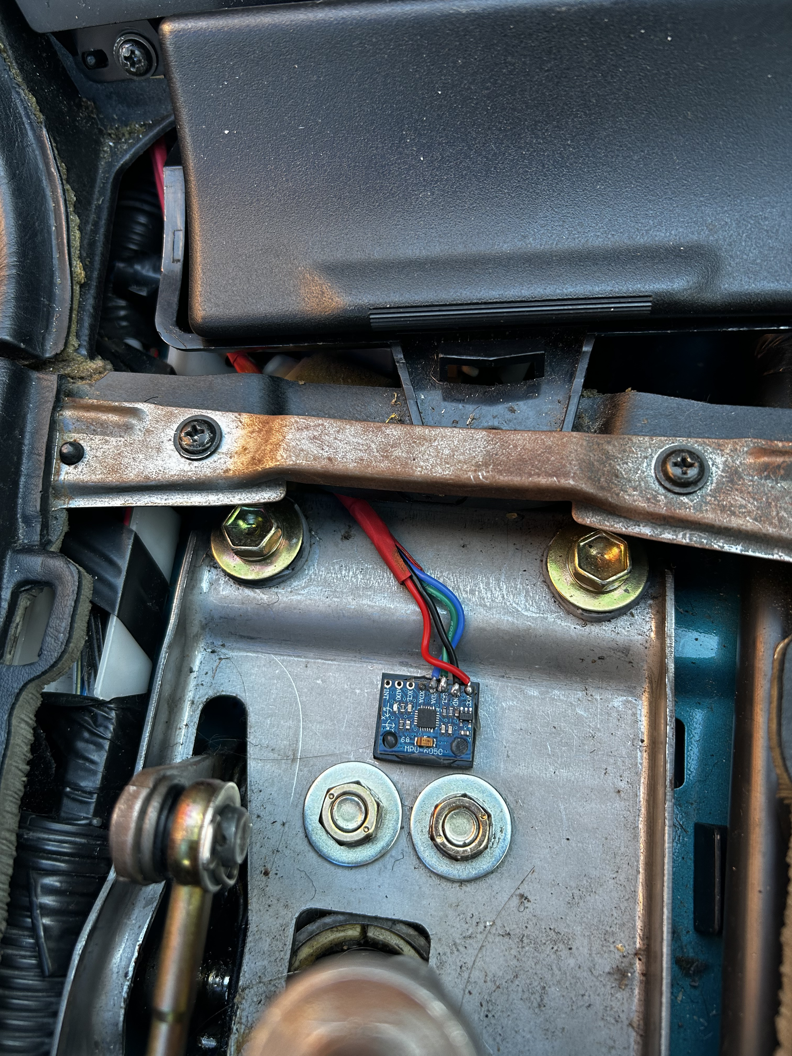
images/installation/sensor_mount.jpeg
